SantiagoP1405/traxxas_2026/README.md

# traxxas_2026
Description will be added later.

Clone repository
```
cd
mkdir Workspaces/
cd Workspaces
mkdir traxxas_ws
cd traxxas_ws
git clone https://github.com/SantiagoP1405/traxxas_2026.git
mv traxxas_2026/ src/
colcon build
source install/setup.bash
```
