SantiagoP1405/traxxas_2026/traxxas_robot_simulation/tools/track_img.png

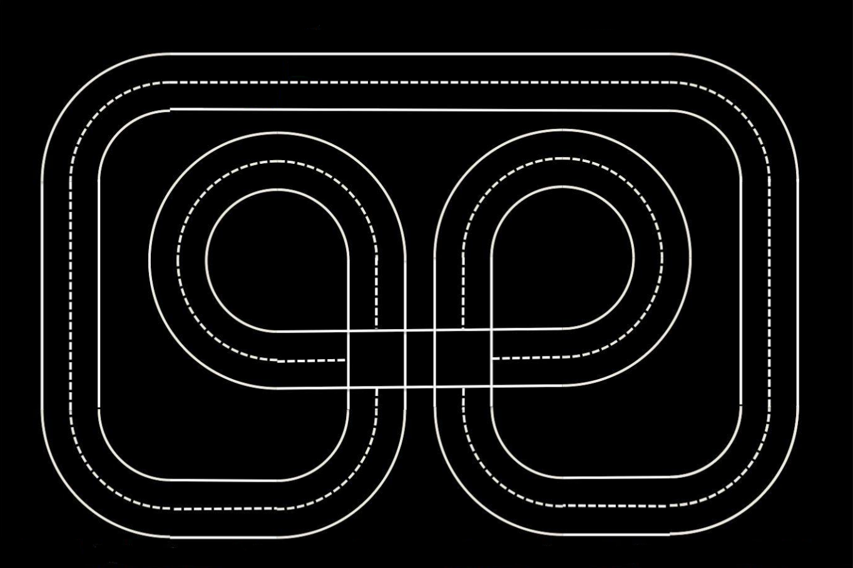
traxxas_robot_simulation/tools/track_img.png
