SantiagoP1405/traxxas_2026/CAD/TRAXXAS_V4/MODEL/rplidar-a2-low-cost-360-degree-laser-range-scanner-1.snapshot.2/LIDAR.png

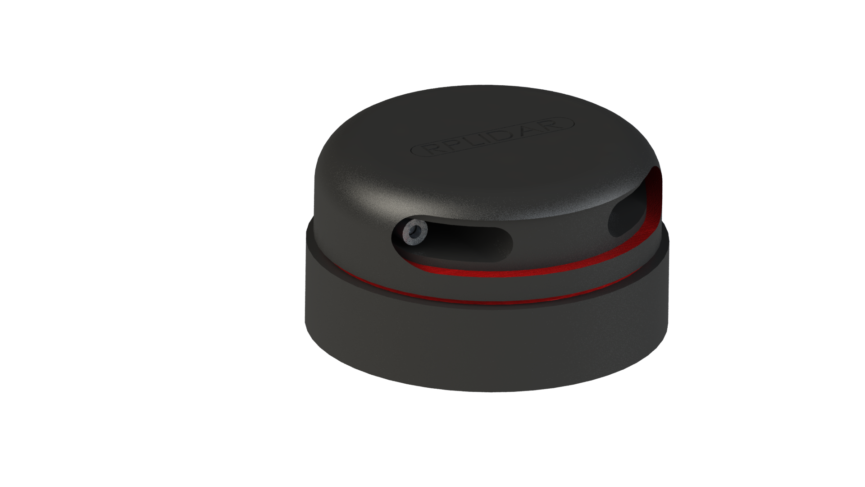
CAD/TRAXXAS_V4/MODEL/rplidar-a2-low-cost-360-degree-laser-range-scanner-1.snapshot.2/LIDAR.png
