SantiagoP1405/traxxas_2026/CAD/DISPLAY_BASE/MODEL/ensamblaje_base.SLDASM

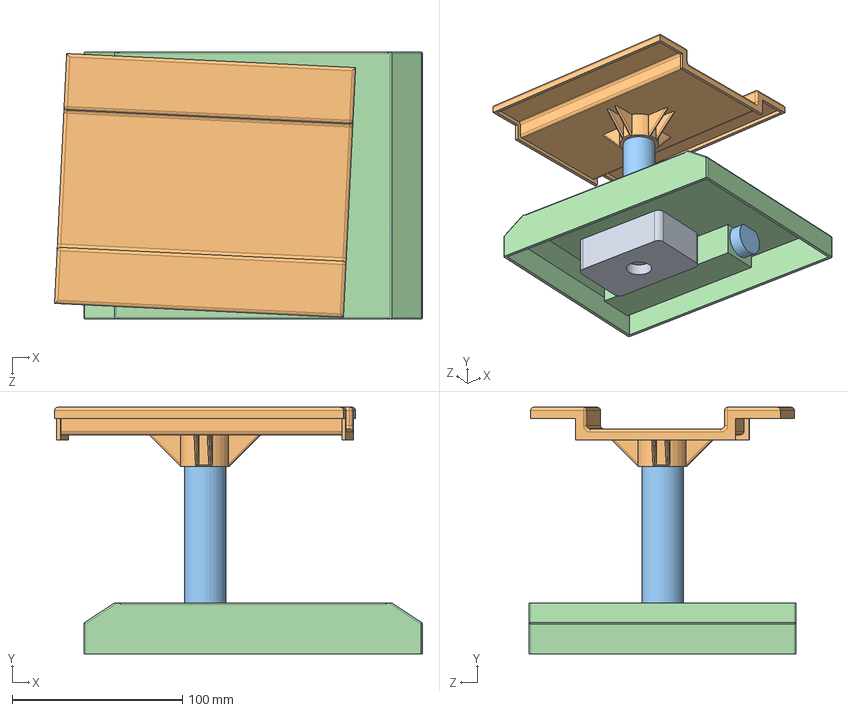
[picture p3: CAD file, 2026-06-15]
CAD/DISPLAY_BASE/MODEL/ensamblaje_base.SLDASM
216.2 x 144.9 x 157.0 mm
base_inferior
pilar x 2
base_superior
soporte
