SantiagoP1405/traxxas_2026/CAD/TRAXXAS_V4/MODEL/rplidar-a2-low-cost-360-degree-laser-range-scanner-1.snapshot.2/LIDAR.STEP

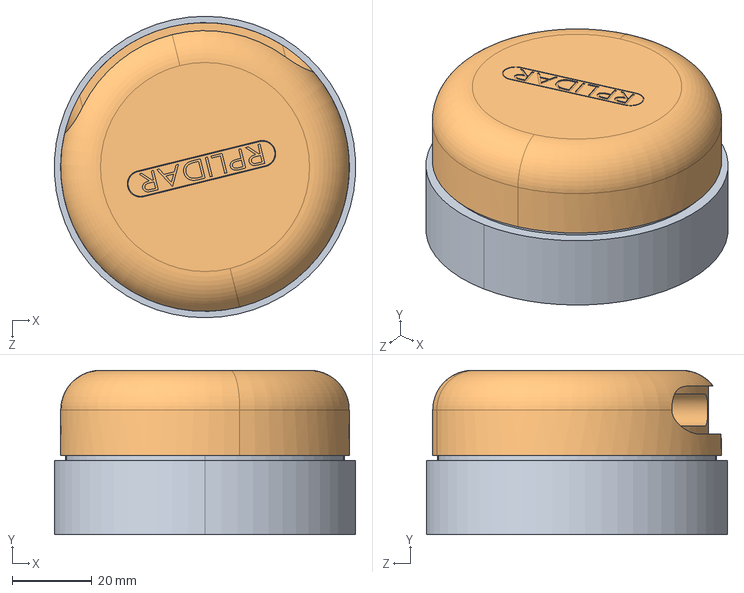
[picture p4: CAD file, 2026-06-16]
CAD/TRAXXAS_V4/MODEL/rplidar-a2-low-cost-360-degree-laser-range-scanner-1.snapshot.2/LIDAR.STEP
75.6 x 41.3 x 75.7 mm
LIDAR_2
LIDAR_1
