SantiagoP1405/traxxas_2026/CAD/DISPLAY_BASE/MODEL/base_superior.SLDPRT

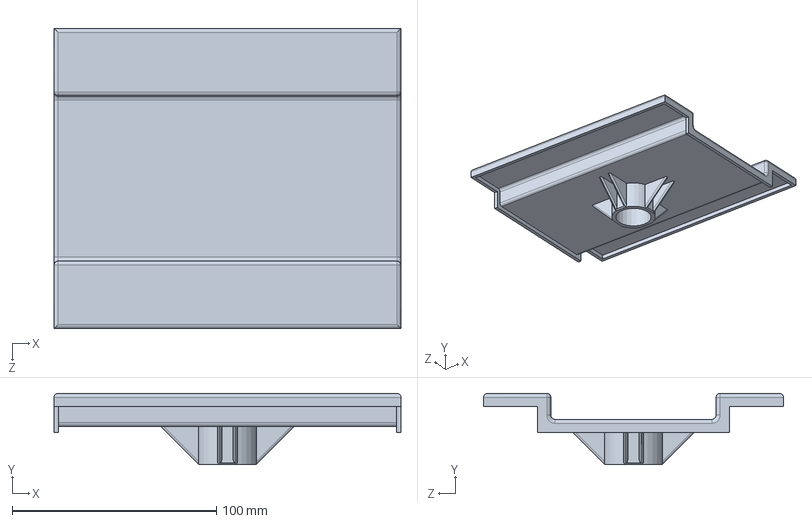
[picture p5: CAD file, 2026-06-15]
CAD/DISPLAY_BASE/MODEL/base_superior.SLDPRT
170.0 x 34.9 x 147.0 mm
