SantiagoP1405/traxxas_2026/CAD/TRAXXAS_V4/MODEL/rplidar-a2-low-cost-360-degree-laser-range-scanner-1.snapshot.2/LIDAR_1.STEP

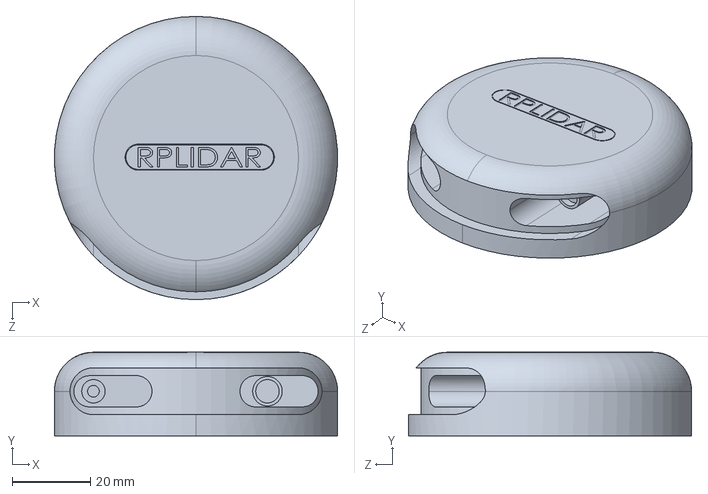
[picture p6: CAD file, 2026-06-16]
CAD/TRAXXAS_V4/MODEL/rplidar-a2-low-cost-360-degree-laser-range-scanner-1.snapshot.2/LIDAR_1.STEP
72.4 x 21.4 x 72.5 mm
