SantiagoP1405/traxxas_2026/CAD/TRAXXAS_V4/MODEL/tapa_lidar.SLDPRT

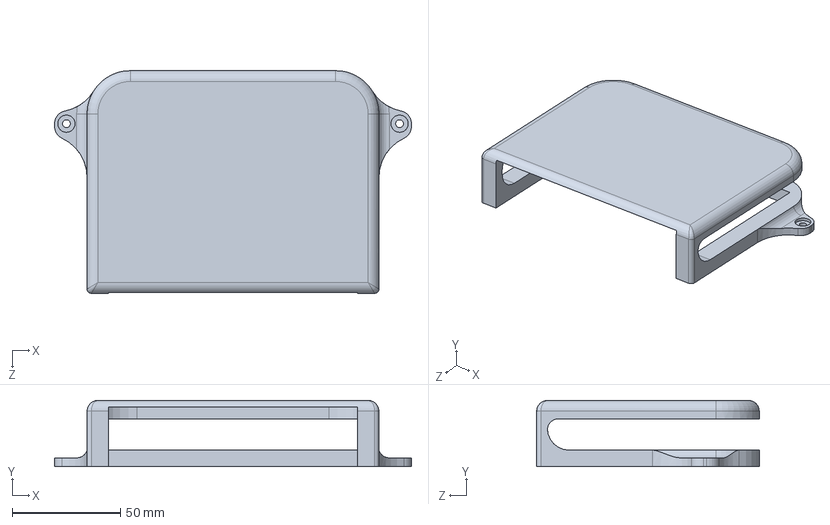
[picture p7: CAD file, 2026-06-16]
CAD/TRAXXAS_V4/MODEL/tapa_lidar.SLDPRT
165.1 x 30.6 x 103.0 mm
