SantiagoP1405/traxxas_2026/CAD/TRAXXAS_V4/STL/tapa_conector_slamtec.STL

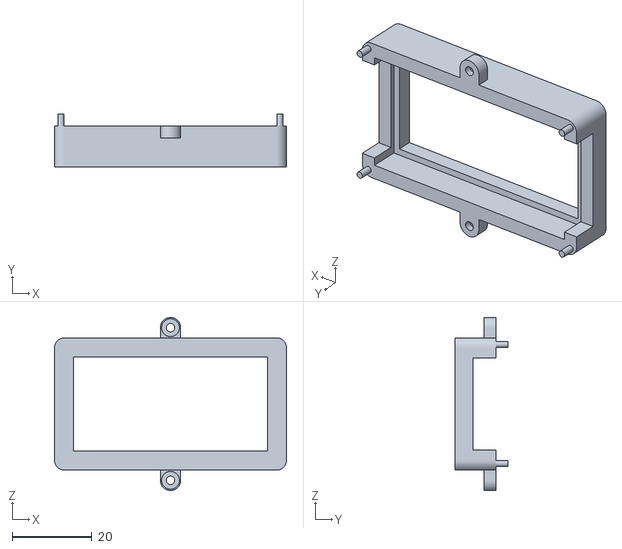
[picture p8: CAD file, 2026-06-16]
CAD/TRAXXAS_V4/STL/tapa_conector_slamtec.STL
58.2 x 13.2 x 43.4
