SantiagoP1405/traxxas_2026/CAD/DISPLAY_BASE/MODEL/soporte.SLDPRT

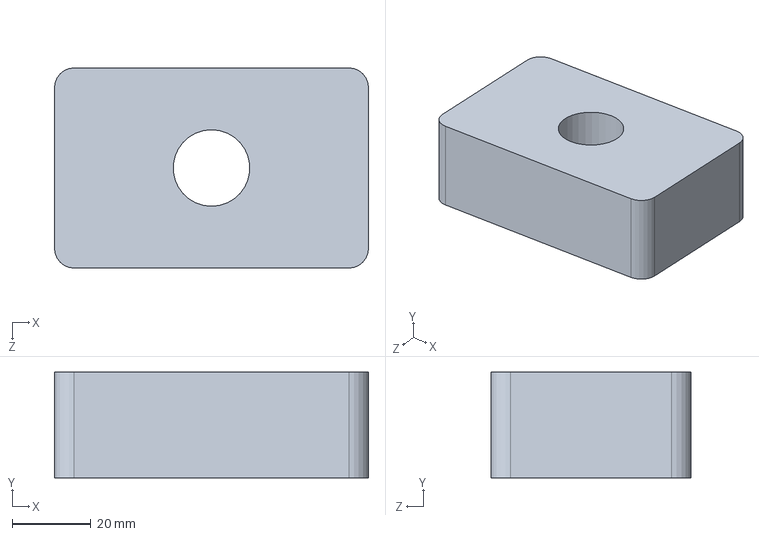
[picture p9: CAD file, 2026-06-15]
CAD/DISPLAY_BASE/MODEL/soporte.SLDPRT
80.0 x 27.0 x 51.0 mm
