SantiagoP1405/traxxas_2026/CAD/TRAXXAS_V4/MODEL/Carroceria2_2.SLDPRT

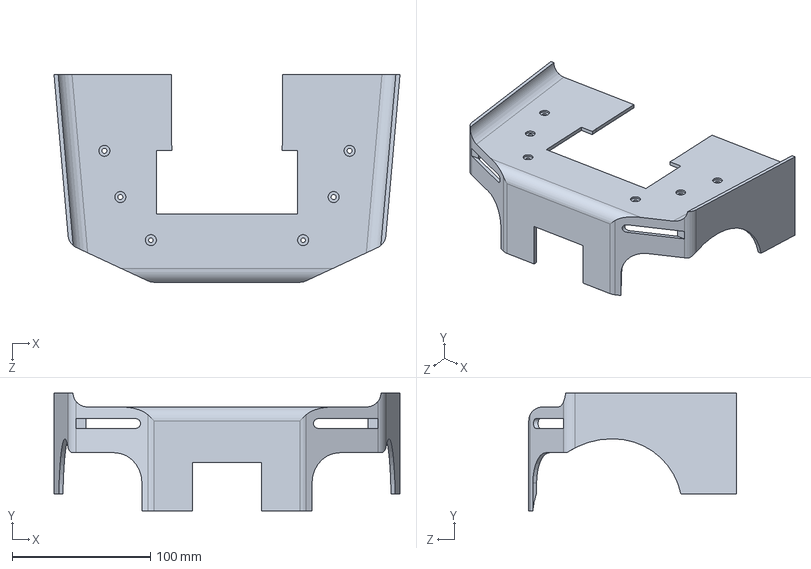
[picture p10: CAD file, 2026-06-16]
CAD/TRAXXAS_V4/MODEL/Carroceria2_2.SLDPRT
250.0 x 85.0 x 150.0 mm
