SantiagoP1405/traxxas_2026/CAD/TRAXXAS_V4/MODEL/rplidar-a2-low-cost-360-degree-laser-range-scanner-1.snapshot.2/LIDAR_2.STEP

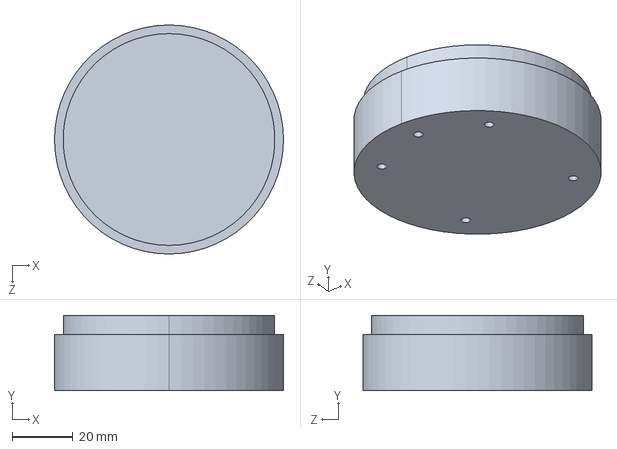
[picture p11: CAD file, 2026-06-16]
CAD/TRAXXAS_V4/MODEL/rplidar-a2-low-cost-360-degree-laser-range-scanner-1.snapshot.2/LIDAR_2.STEP
75.7 x 24.9 x 75.7 mm
