SantiagoP1405/traxxas_2026/CAD/TRAXXAS_V4/STL/aros_suspension_V2.STL

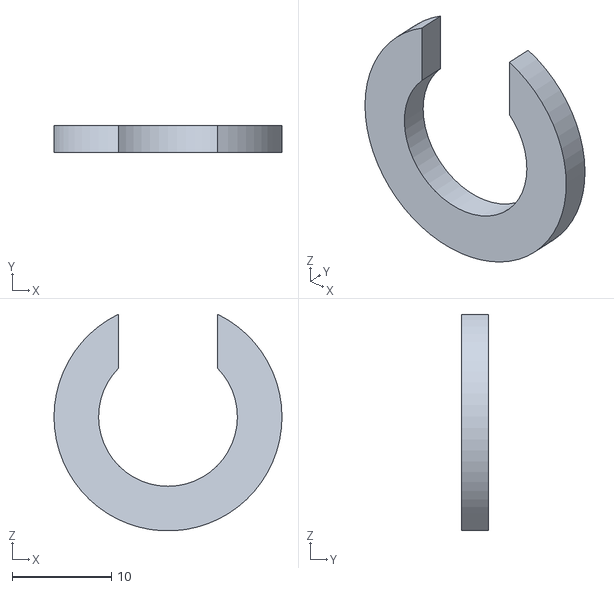
[picture p12: CAD file, 2026-06-16]
CAD/TRAXXAS_V4/STL/aros_suspension_V2.STL
23.0 x 2.75 x 21.8
