SantiagoP1405/traxxas_2026/CAD/DISPLAY_BASE/MODEL/base_inferior.SLDPRT

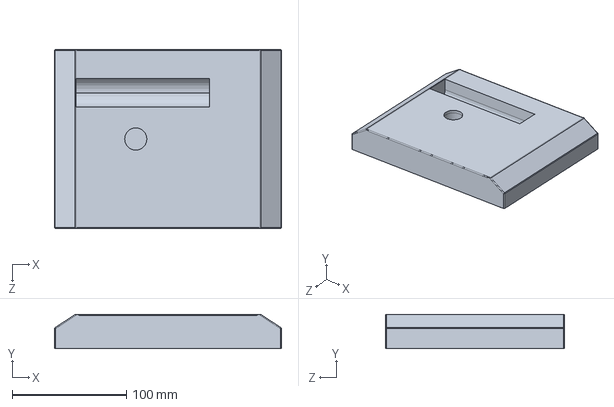
[picture p13: CAD file, 2026-06-15]
CAD/DISPLAY_BASE/MODEL/base_inferior.SLDPRT
199.0 x 30.0 x 157.0 mm
