SantiagoP1405/traxxas_2026/CAD/DISPLAY_BASE/MODEL/pilar_v2.SLDPRT

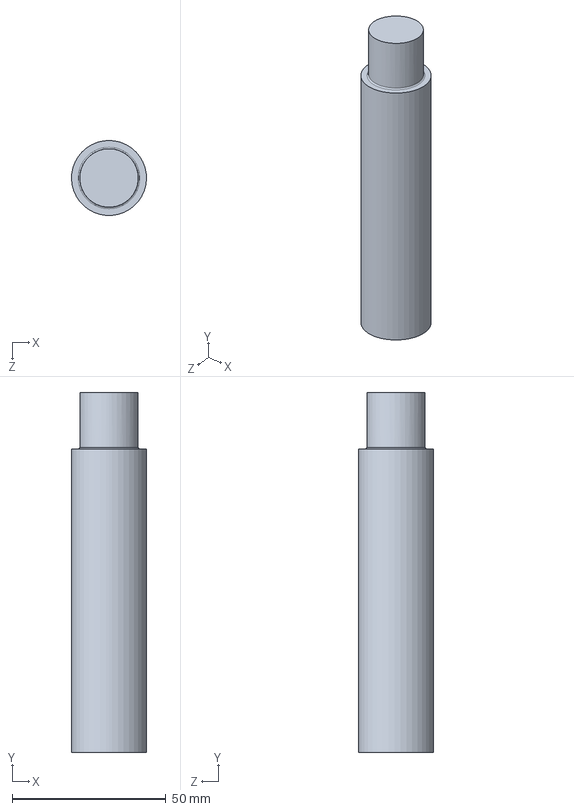
[picture p14: CAD file, 2026-06-15]
CAD/DISPLAY_BASE/MODEL/pilar_v2.SLDPRT
24.4 x 117.0 x 24.4 mm
