SantiagoP1405/traxxas_2026/CAD/TRAXXAS_V4/MODEL/Carroceria2_1_4.SLDPRT

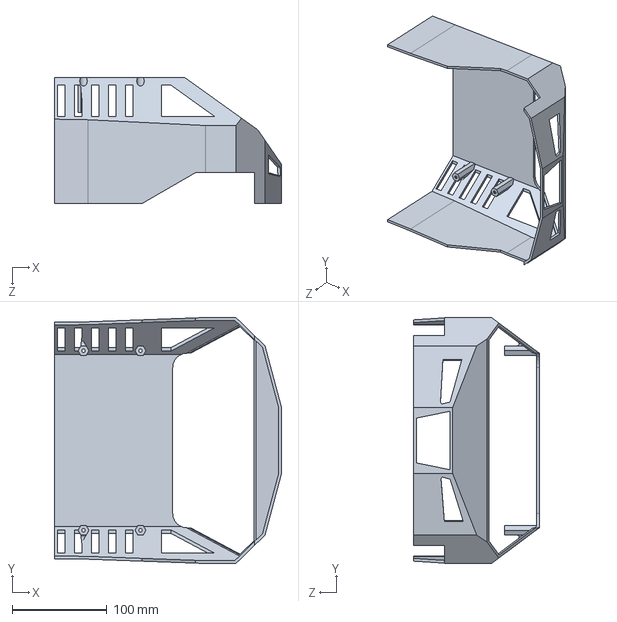
[picture p15: CAD file, 2026-06-16]
CAD/TRAXXAS_V4/MODEL/Carroceria2_1_4.SLDPRT
240.0 x 260.0 x 133.0 mm
