SantiagoP1405/traxxas_2026/CAD/TRAXXAS_V4/STL/test_ultrasonico_v3_1.STL

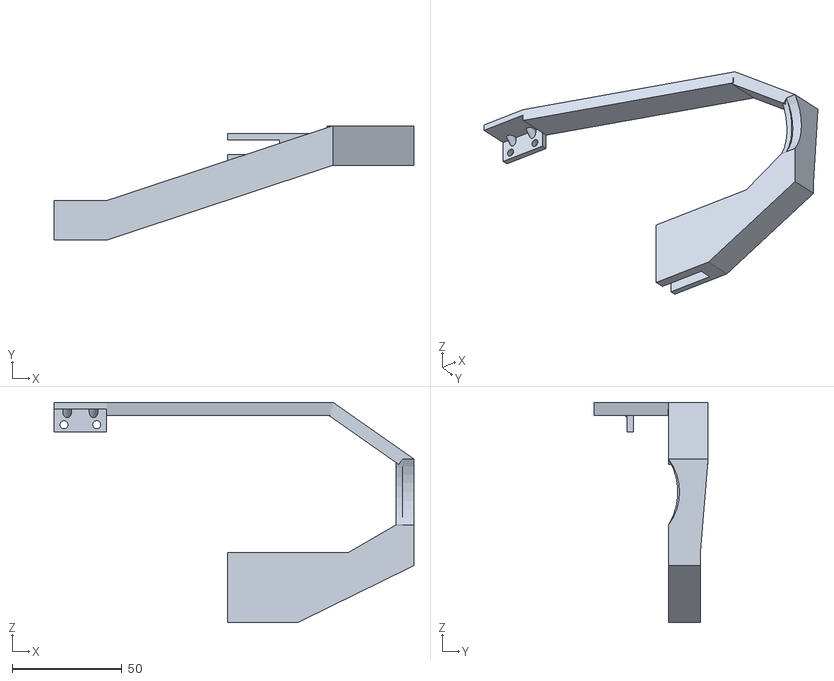
[picture p16: CAD file, 2026-06-16]
CAD/TRAXXAS_V4/STL/test_ultrasonico_v3_1.STL
163.9 x 52.0 x 100.3
