SantiagoP1405/traxxas_2026/CAD/TRAXXAS_V4/MODEL/HC-SR04.SLDPRT

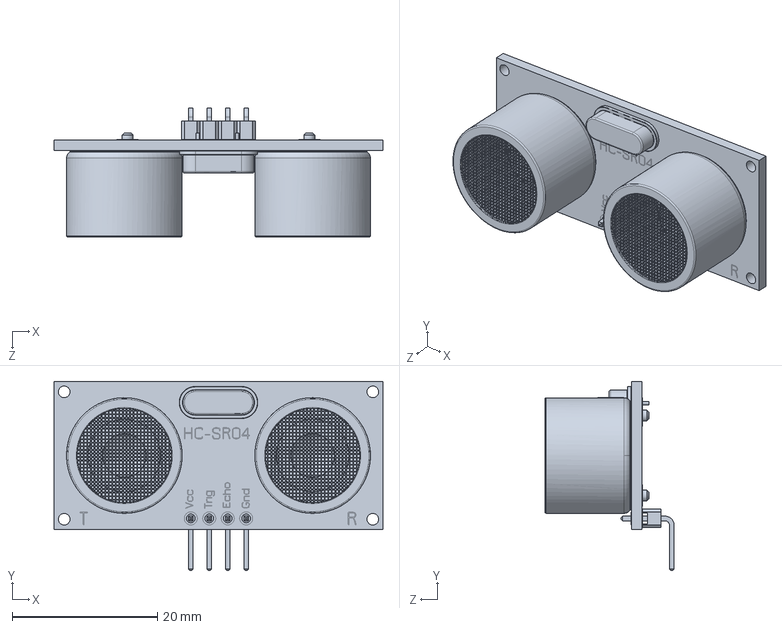
[picture p17: CAD file, 2026-06-16]
CAD/TRAXXAS_V4/MODEL/HC-SR04.SLDPRT
45.2 x 26.0 x 17.8 mm
