SantiagoP1405/traxxas_2026/CAD/TRAXXAS_V4/STL/test_ultrasonico_trasero.STL

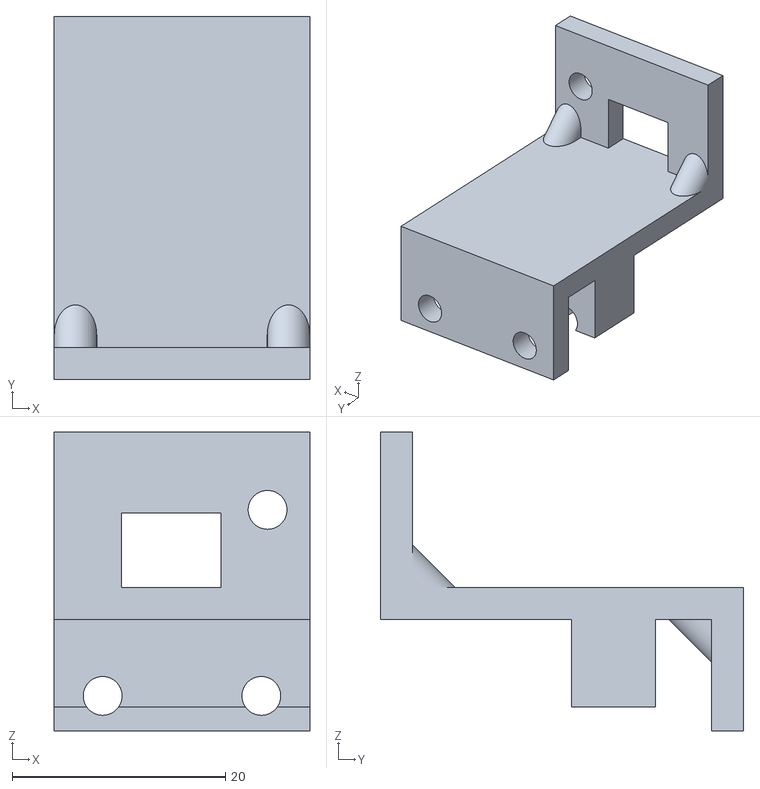
[picture p18: CAD file, 2026-06-16]
CAD/TRAXXAS_V4/STL/test_ultrasonico_trasero.STL
24.0 x 34.1 x 28.1
