SantiagoP1405/traxxas_2026/CAD/TRAXXAS_V4/MODEL/segundo_piso_v3_2.SLDPRT

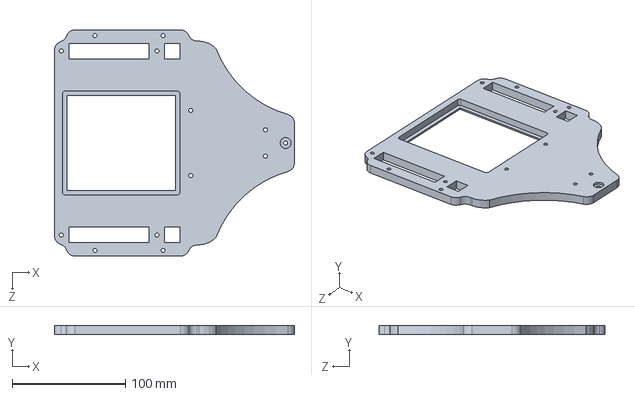
[picture p19: CAD file, 2026-06-16]
CAD/TRAXXAS_V4/MODEL/segundo_piso_v3_2.SLDPRT
212.0 x 8.00 x 200.0 mm
