SantiagoP1405/traxxas_2026/CAD/TRAXXAS_V4/STL/base_conector_slamtec.STL

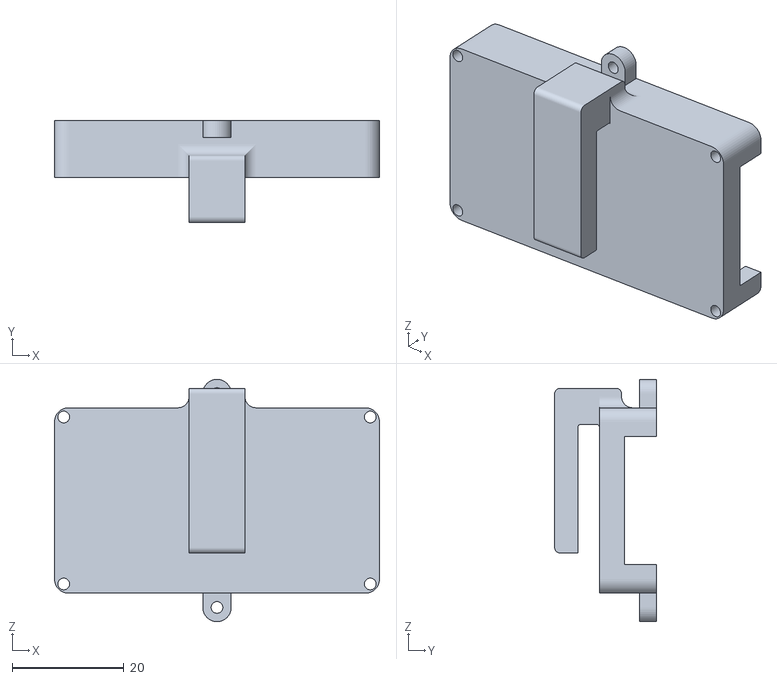
[picture p20: CAD file, 2026-06-16]
CAD/TRAXXAS_V4/STL/base_conector_slamtec.STL
58.2 x 18.2 x 43.4
