SantiagoP1405/traxxas_2026/CAD/TRAXXAS_V4/MODEL/separador_30mm.SLDPRT

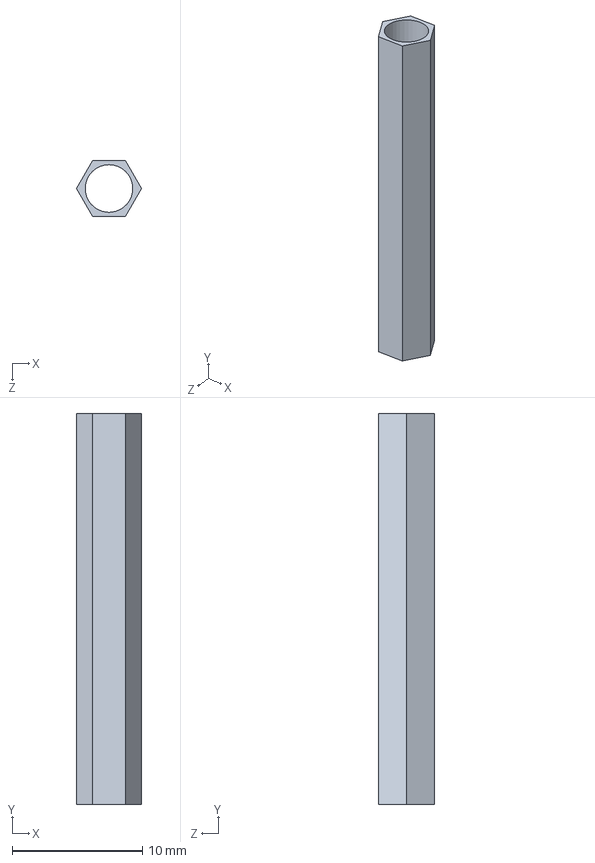
[picture p21: CAD file, 2026-06-16]
CAD/TRAXXAS_V4/MODEL/separador_30mm.SLDPRT
5.00 x 30.0 x 4.33 mm
