SantiagoP1405/traxxas_2026/CAD/TRAXXAS_V4/STL/hexagonos_llantas.STL

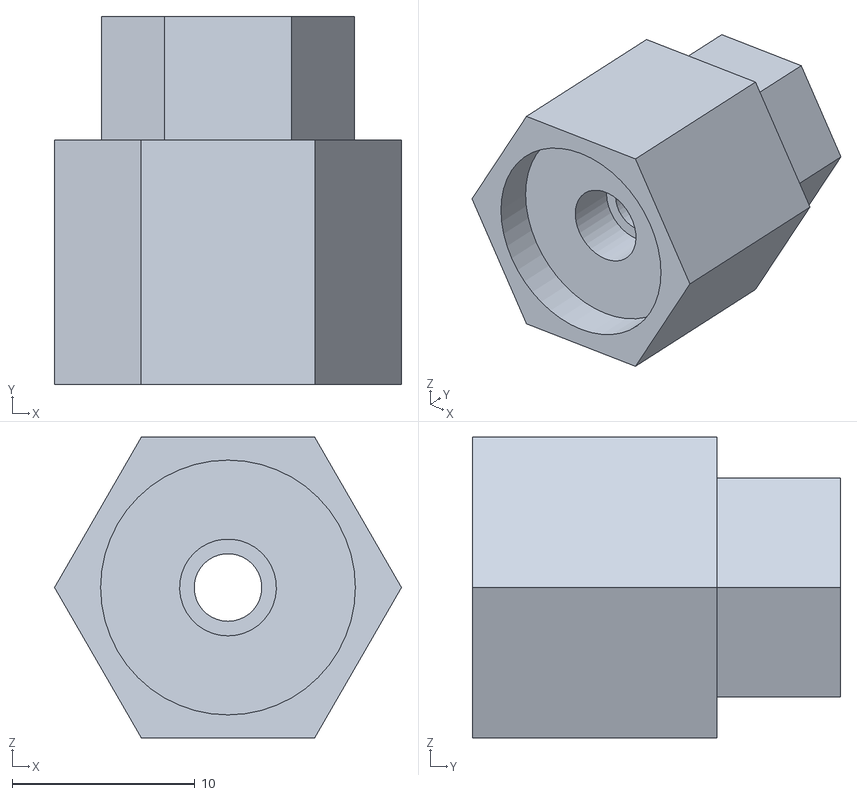
[picture p22: CAD file, 2026-06-16]
CAD/TRAXXAS_V4/STL/hexagonos_llantas.STL
19.0 x 20.1 x 16.5
