SantiagoP1405/traxxas_2026/CAD/TRAXXAS_V4/MODEL/base_rplidar_adapter.SLDPRT

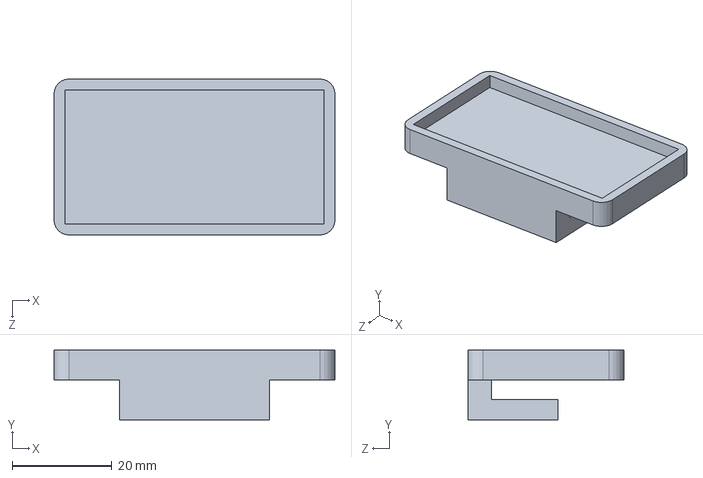
[picture p23: CAD file, 2026-06-16]
CAD/TRAXXAS_V4/MODEL/base_rplidar_adapter.SLDPRT
56.2 x 14.0 x 31.2 mm
