SantiagoP1405/traxxas_2026/CAD/TRAXXAS_V4/STL/test_tuerca.STL

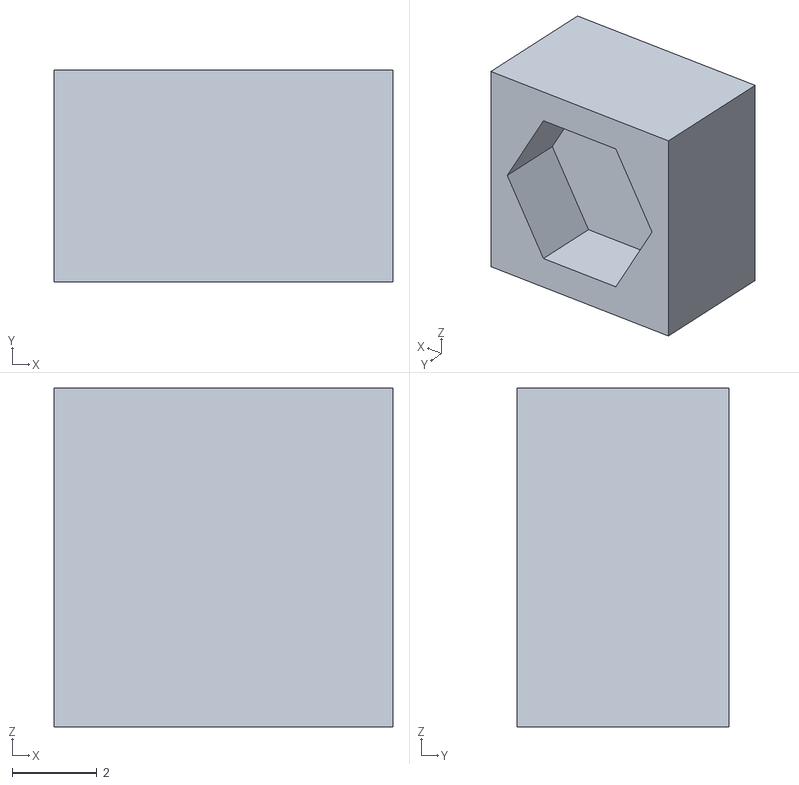
[picture p24: CAD file, 2026-06-16]
CAD/TRAXXAS_V4/STL/test_tuerca.STL
8.00 x 5.00 x 8.00
