SantiagoP1405/traxxas_2026/CAD/TRAXXAS_V4/MODEL/primer_piso.SLDPRT

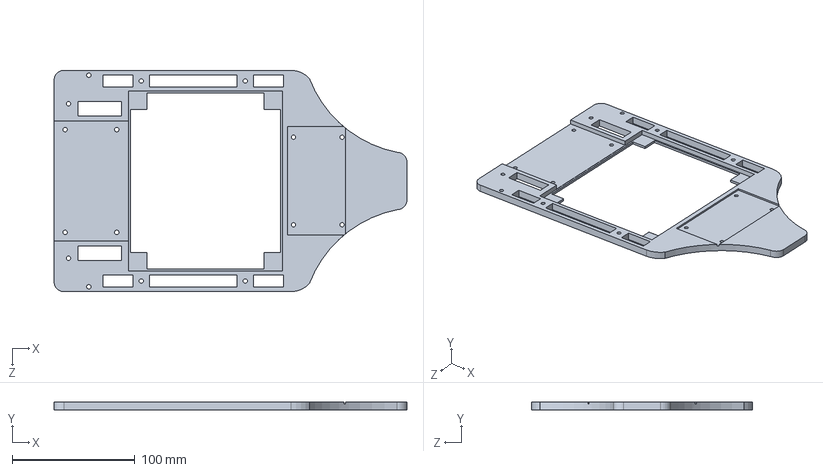
[picture p25: CAD file, 2026-06-16]
CAD/TRAXXAS_V4/MODEL/primer_piso.SLDPRT
287.0 x 6.35 x 180.0 mm
