SantiagoP1405/traxxas_2026/CAD/TRAXXAS_V4/MODEL/base_lidar.SLDPRT

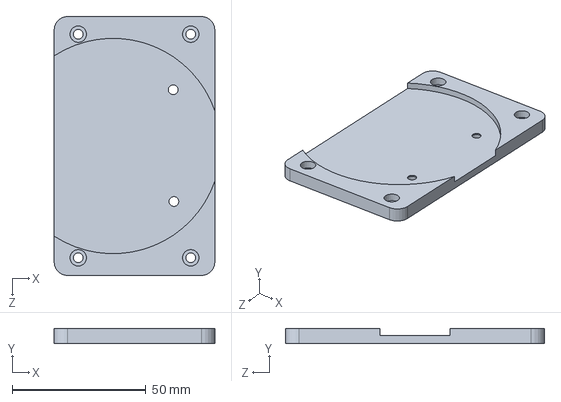
[picture p26: CAD file, 2026-06-16]
CAD/TRAXXAS_V4/MODEL/base_lidar.SLDPRT
60.0 x 5.50 x 96.7 mm
