SantiagoP1405/traxxas_2026/CAD/TRAXXAS_V4/MODEL/separador.SLDPRT

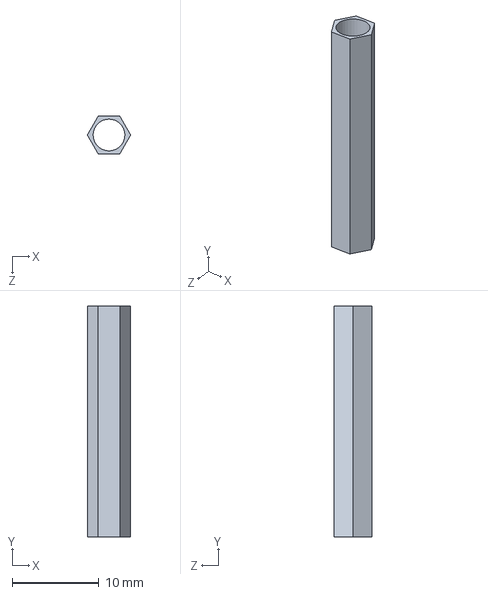
[picture p27: CAD file, 2026-06-16]
CAD/TRAXXAS_V4/MODEL/separador.SLDPRT
5.00 x 26.6 x 4.33 mm
