SantiagoP1405/traxxas_2026/CAD/TRAXXAS_V4/MODEL/base_ultrasonico_trasero_v3.SLDPRT

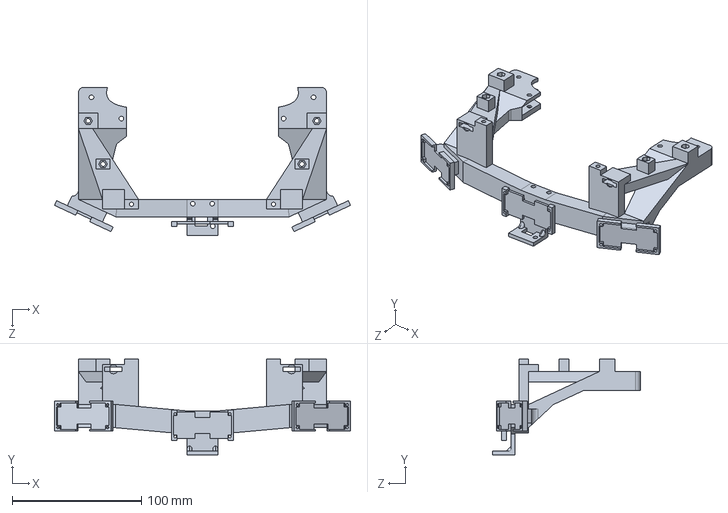
[picture p28: CAD file, 2026-06-16]
CAD/TRAXXAS_V4/MODEL/base_ultrasonico_trasero_v3.SLDPRT
229.3 x 74.3 x 114.9 mm
