SantiagoP1405/traxxas_2026/CAD/TRAXXAS_V4/MODEL/separador_15mm.SLDPRT

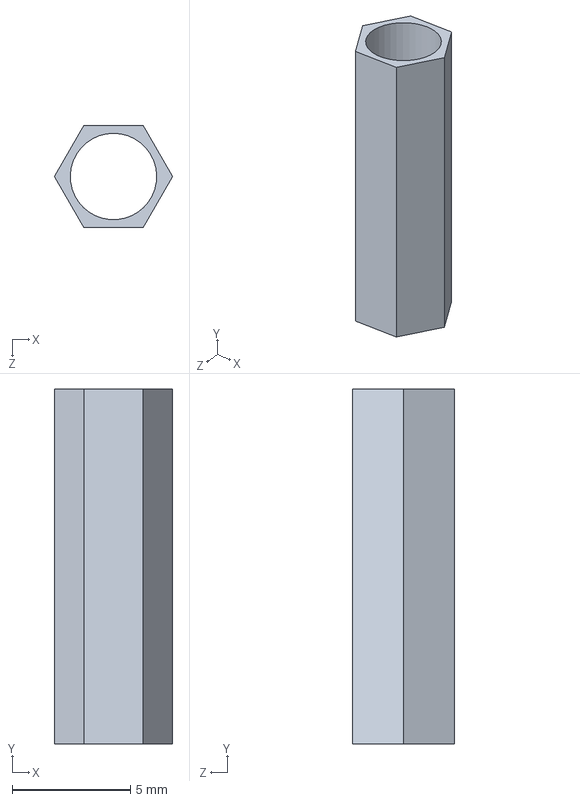
[picture p29: CAD file, 2026-06-16]
CAD/TRAXXAS_V4/MODEL/separador_15mm.SLDPRT
5.00 x 15.0 x 4.33 mm
