SantiagoP1405/traxxas_2026/CAD/TRAXXAS_V4/MODEL/base_zed.SLDPRT

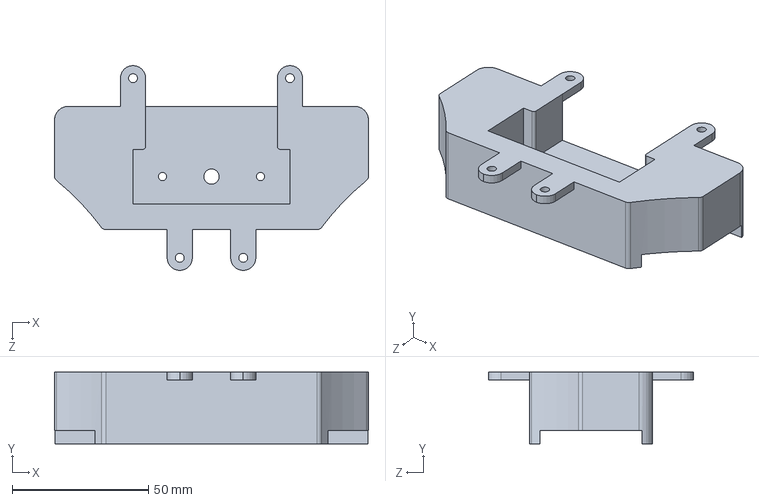
[picture p30: CAD file, 2026-06-15]
CAD/TRAXXAS_V4/MODEL/base_zed.SLDPRT
115.4 x 26.4 x 75.3 mm
