SantiagoP1405/traxxas_2026/CAD/TRAXXAS_V4/MODEL/ensamblaje_sin_jetson.SLDASM

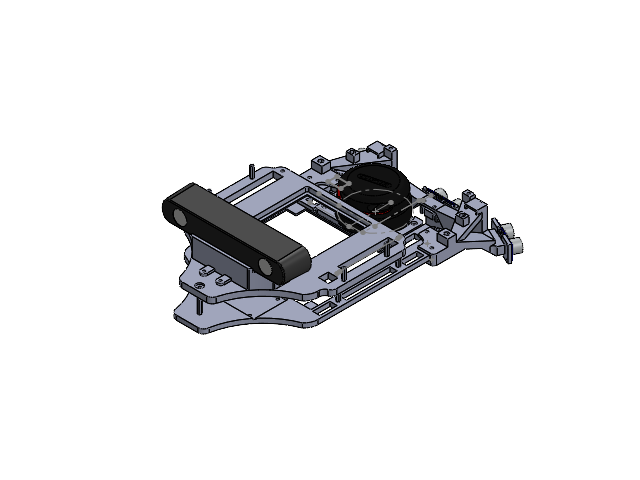
[picture p32: CAD file, 2026-06-16]
CAD/TRAXXAS_V4/MODEL/ensamblaje_sin_jetson.SLDASM
segundo_piso_v3_2
separador x 4
primer_piso
base_ultrasonico_trasero_v3
base_zed
optic_2.step x 2
eBom-FreeParts_2.step
separador_30mm
base_lidar
LIDAR_2
LIDAR_1
HC-SR04 x 3
leds Geometry.stp
pin.stp
smd_10k Geometry.stp x 2
cover.stp x 2
smd_150 Geometry.stp
cover2.stp
Surf Geometry.stp x 2
cover3.stp x 2
smd_1k Geometry.stp x 2
cover4.stp x 2
IC_smd_8.stp
LED_SMD.stp x 2
pot Geometry.stp
pin2.stp
leds2 Geometry.stp
pins.stp
Board Geometry.stp
TXT.stp
4PinsOut Geometry.stp
pin3.stp
TCRT5000_1.stp
separador_15mm x 4
