SantiagoP1405/traxxas_2026/CAD/TRAXXAS_V4/MODEL/ensamblaje_lidar.SLDASM

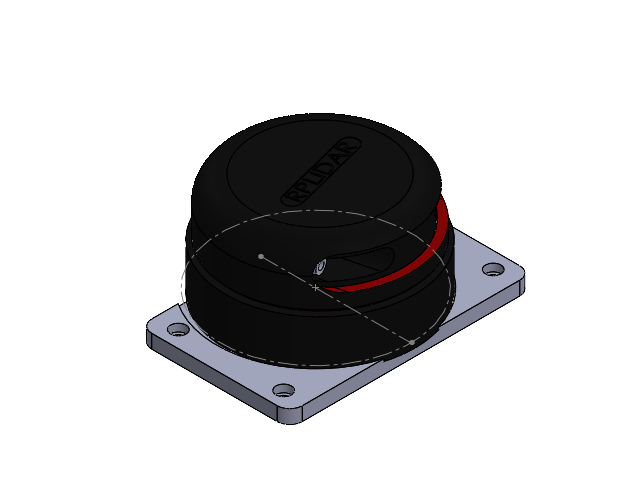
[picture p33: CAD file, 2026-06-16]
CAD/TRAXXAS_V4/MODEL/ensamblaje_lidar.SLDASM
base_lidar
LIDAR_2
LIDAR_1
