SantiagoP1405/traxxas_2026/CAD/TRAXXAS_V4/MODEL/ensamblaje_basez_2_zed.SLDASM

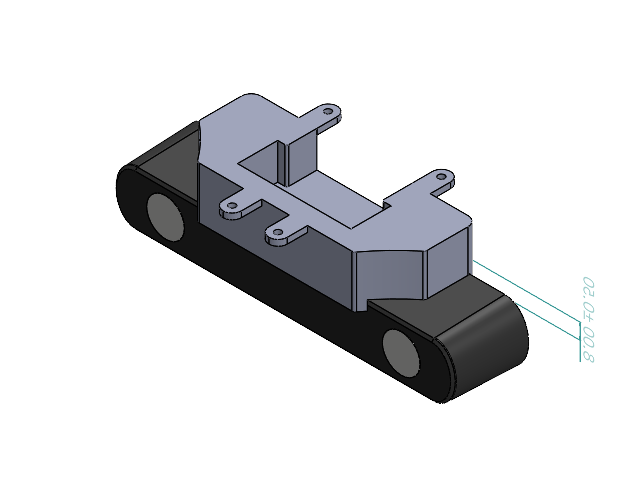
[picture p34: CAD file, 2026-06-15]
CAD/TRAXXAS_V4/MODEL/ensamblaje_basez_2_zed.SLDASM
base_zed
optic_2.step x 2
eBom-FreeParts_2.step
