SantiagoP1405/traxxas_2026/(list of files, cad)

Other CAD files:
CAD/DISPLAY_BASE/MODEL/pilar.SLDPRT
CAD/DISPLAY_BASE/DRAW/base_inferior.SLDDRW
CAD/DISPLAY_BASE/DRAW/base_superior.SLDDRW
CAD/DISPLAY_BASE/DRAW/pilar.SLDDRW
CAD/DISPLAY_BASE/DRAW/pilar_v2.SLDDRW
CAD/DISPLAY_BASE/DRAW/soporte.SLDDRW
CAD/DISPLAY_BASE/STL/base_inferior.STL
CAD/DISPLAY_BASE/STL/base_superior.STL
CAD/DISPLAY_BASE/STL/pilar.STL
CAD/DISPLAY_BASE/STL/soporte.STL
CAD/TRAXXAS_V1/DRAW/platform_deck_technical_drawing.dwg
CAD/TRAXXAS_V1/DRAW/platform_deck_v3_2_technical_drawing.dwg
CAD/TRAXXAS_V1/DRAW/platform_deck_v3_3_technical_drawing.dwg
CAD/TRAXXAS_V1/MODEL/Platform_Deck.ipt
CAD/TRAXXAS_V1/MODEL/Platform_Deck_V3_2.ipt
CAD/TRAXXAS_V1/MODEL/Platform_Deck_V3_3.ipt
CAD/TRAXXAS_V1/MODEL/platform_deck.ipt
CAD/TRAXXAS_V1/MODEL/platform_deck_v3_2.ipt
CAD/TRAXXAS_V1/MODEL/platform_deck_v3_3.ipt
CAD/TRAXXAS_V2/DRAW/base_lidar.SLDDRW
CAD/TRAXXAS_V2/DRAW/primer_piso_v2.SLDDRW
CAD/TRAXXAS_V2/DRAW/right_base_ultrasonic.SLDDRW
CAD/TRAXXAS_V2/DRAW/segundo_piso.SLDDRW
CAD/TRAXXAS_V2/MODEL/HC-SR04.SLDPRT
CAD/TRAXXAS_V2/MODEL/base_lidar.SLDPRT
CAD/TRAXXAS_V2/MODEL/left_ultrasonic_2_base - copia.SLDASM
CAD/TRAXXAS_V2/MODEL/primer_piso_v2.SLDPRT
CAD/TRAXXAS_V2/MODEL/right_base_ultrasonic.SLDPRT
CAD/TRAXXAS_V2/MODEL/right_ultrasonic_2_base.SLDASM
CAD/TRAXXAS_V2/MODEL/segundo_piso.SLDPRT
CAD/TRAXXAS_V3/DRAW/carroceria_atras.SLDDRW
CAD/TRAXXAS_V3/DRAW/carroceria_frente.SLDDRW
CAD/TRAXXAS_V3/MODEL/LIDAR.SLDASM
CAD/TRAXXAS_V3/MODEL/ZED2i.step
CAD/TRAXXAS_V3/MODEL/aros_suspension_V1.SLDPRT
CAD/TRAXXAS_V3/MODEL/aros_suspension_V2.SLDPRT
CAD/TRAXXAS_V3/MODEL/carroceria_atras.SLDPRT
CAD/TRAXXAS_V3/MODEL/carroceria_frente.SLDPRT
CAD/TRAXXAS_V3/MODEL/hexagonos_llantas.SLDPRT
CAD/TRAXXAS_V3/MODEL/tcrt5000.stp
CAD/TRAXXAS_V3/STL/carroceria_atras.3mf
CAD/TRAXXAS_V3/STL/carroceria_atras.STL
CAD/TRAXXAS_V3/STL/carroceria_frente.3mf
CAD/TRAXXAS_V3/STL/carroceria_frente.STL
CAD/TRAXXAS_V4/DRAW/Carroceria2_1_4.SLDDRW
CAD/TRAXXAS_V4/DRAW/Carroceria2_2.SLDDRW
CAD/TRAXXAS_V4/DRAW/aros_suspension.SLDDRW
CAD/TRAXXAS_V4/DRAW/base_lidar.SLDDRW
CAD/TRAXXAS_V4/DRAW/base_rplidar_adapter.SLDDRW
CAD/TRAXXAS_V4/DRAW/base_ultrasonico_trasero_v3.SLDDRW
CAD/TRAXXAS_V4/DRAW/base_zed.SLDDRW
CAD/TRAXXAS_V4/DRAW/hexagonos_llantas.SLDDRW
CAD/TRAXXAS_V4/DRAW/primer_piso.SLDDRW
CAD/TRAXXAS_V4/DRAW/segundo_piso_v3_2.SLDDRW
CAD/TRAXXAS_V4/DRAW/separador.SLDDRW
CAD/TRAXXAS_V4/DRAW/tapa_lidar.SLDDRW
CAD/TRAXXAS_V4/MODEL/rplidar-a2-low-cost-360-degree-laser-range-scanner-1.snapshot.2/LIDAR.SLDASM
CAD/TRAXXAS_V4/MODEL/rplidar-a2-low-cost-360-degree-laser-range-scanner-1.snapshot.2/LIDAR.SLDPRT
CAD/TRAXXAS_V4/MODEL/rplidar-a2-low-cost-360-degree-laser-range-scanner-1.snapshot.2/LIDAR_1.SLDPRT
CAD/TRAXXAS_V4/MODEL/rplidar-a2-low-cost-360-degree-laser-range-scanner-1.snapshot.2/LIDAR_2.SLDPRT
CAD/TRAXXAS_V4/STL/Carroceria2_1_4.STL
CAD/TRAXXAS_V4/STL/Carroceria2_2.STL
CAD/TRAXXAS_V4/STL/base_lidar.STL
CAD/TRAXXAS_V4/STL/base_rplidar_adapter.STL
CAD/TRAXXAS_V4/STL/base_ultrasonico_trasero_v2.3mf
CAD/TRAXXAS_V4/STL/base_ultrasonico_trasero_v2.STL
CAD/TRAXXAS_V4/STL/base_ultrasonico_trasero_v3.3mf
CAD/TRAXXAS_V4/STL/base_ultrasonico_trasero_v3.STL
CAD/TRAXXAS_V4/STL/primer_piso.STL
CAD/TRAXXAS_V4/STL/segundo_piso_v3_2.STL
CAD/TRAXXAS_V4/STL/tapa_lidar.STL
CAD/TRAXXAS_V4/STL/test_ultrasonico_v3.STL
