SantiagoP1405/traxxas_2026/AI_models/results_lane_detector_m/results.csv

epoch | time | train/box_loss | train/seg_loss | train/cls_loss | train/dfl_loss | train/sem_loss | metrics/precision(B) | metrics/recall(B) | metrics/mAP50(B) | metrics/mAP50-95(B) | metrics/precision(M) | metrics/recall(M) | metrics/mAP50(M) | metrics/mAP50-95(M) | val/box_loss | val/seg_loss | val/cls_loss | val/dfl_loss | val/sem_loss | lr/pg0 | lr/pg1 | lr/pg2
1 | 140.978 | 0.71714 | 0.91427 | 0.87065 | 1.00846 | 0 | 0.67859 | 0.62909 | 0.61956 | 0.49126 | 0.6948 | 0.65338 | 0.62339 | 0.45668 | 0.83601 | 0.74295 | 2.47791 | 1.15765 | 0 | 0.000332288 | 0.000332288 | 0.0671034
2 | 286.201 | 0.70022 | 0.79 | 0.75639 | 0.99613 | 0 | 0.76937 | 0.69865 | 0.73232 | 0.60617 | 0.76487 | 0.70743 | 0.73654 | 0.56025 | 0.69849 | 0.58177 | 1.51866 | 1.08105 | 0 | 0.000661229 | 0.000661229 | 0.0340991
3 | 430.981 | 0.6828 | 0.77687 | 0.71439 | 0.98867 | 0 | 0.73797 | 0.74932 | 0.75818 | 0.60499 | 0.74793 | 0.7518 | 0.76638 | 0.58133 | 0.71419 | 0.60118 | 1.4174 | 1.10313 | 0 | 0.000985769 | 0.000985769 | 0.00109026
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
