SantiagoP1405/traxxas_2026/AI_models/results_lane_detector_m/BoxPR_curve.png

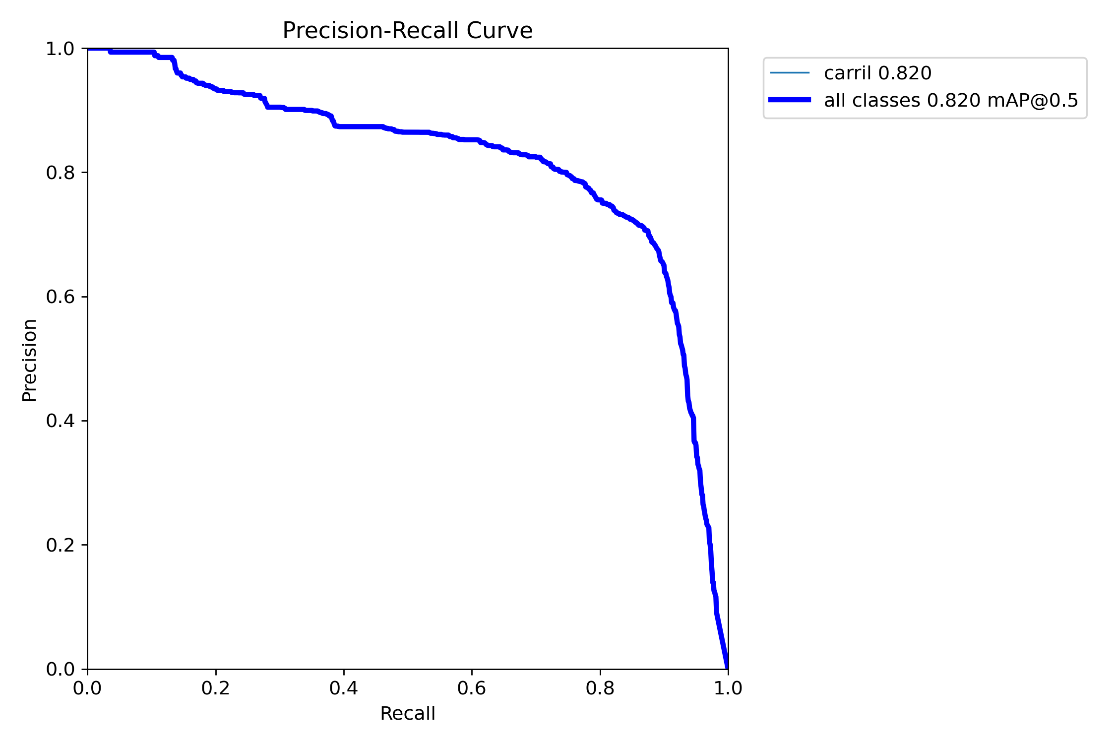
AI_models/results_lane_detector_m/BoxPR_curve.png
