SantiagoP1405/traxxas_2026/AI_models/results_lane_detector_m/confusion_matrix_normalized.png

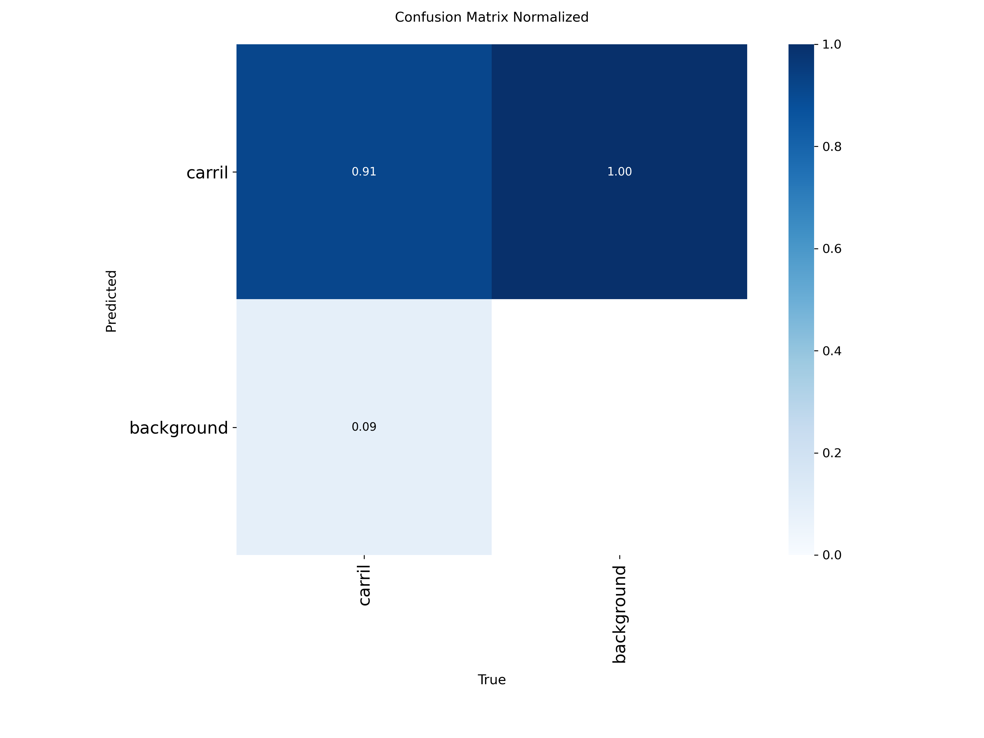
AI_models/results_lane_detector_m/confusion_matrix_normalized.png
