SantiagoP1405/traxxas_2026/CAD/TRAXXAS_V4/DRAW/Carroceria2_1_4.pdf

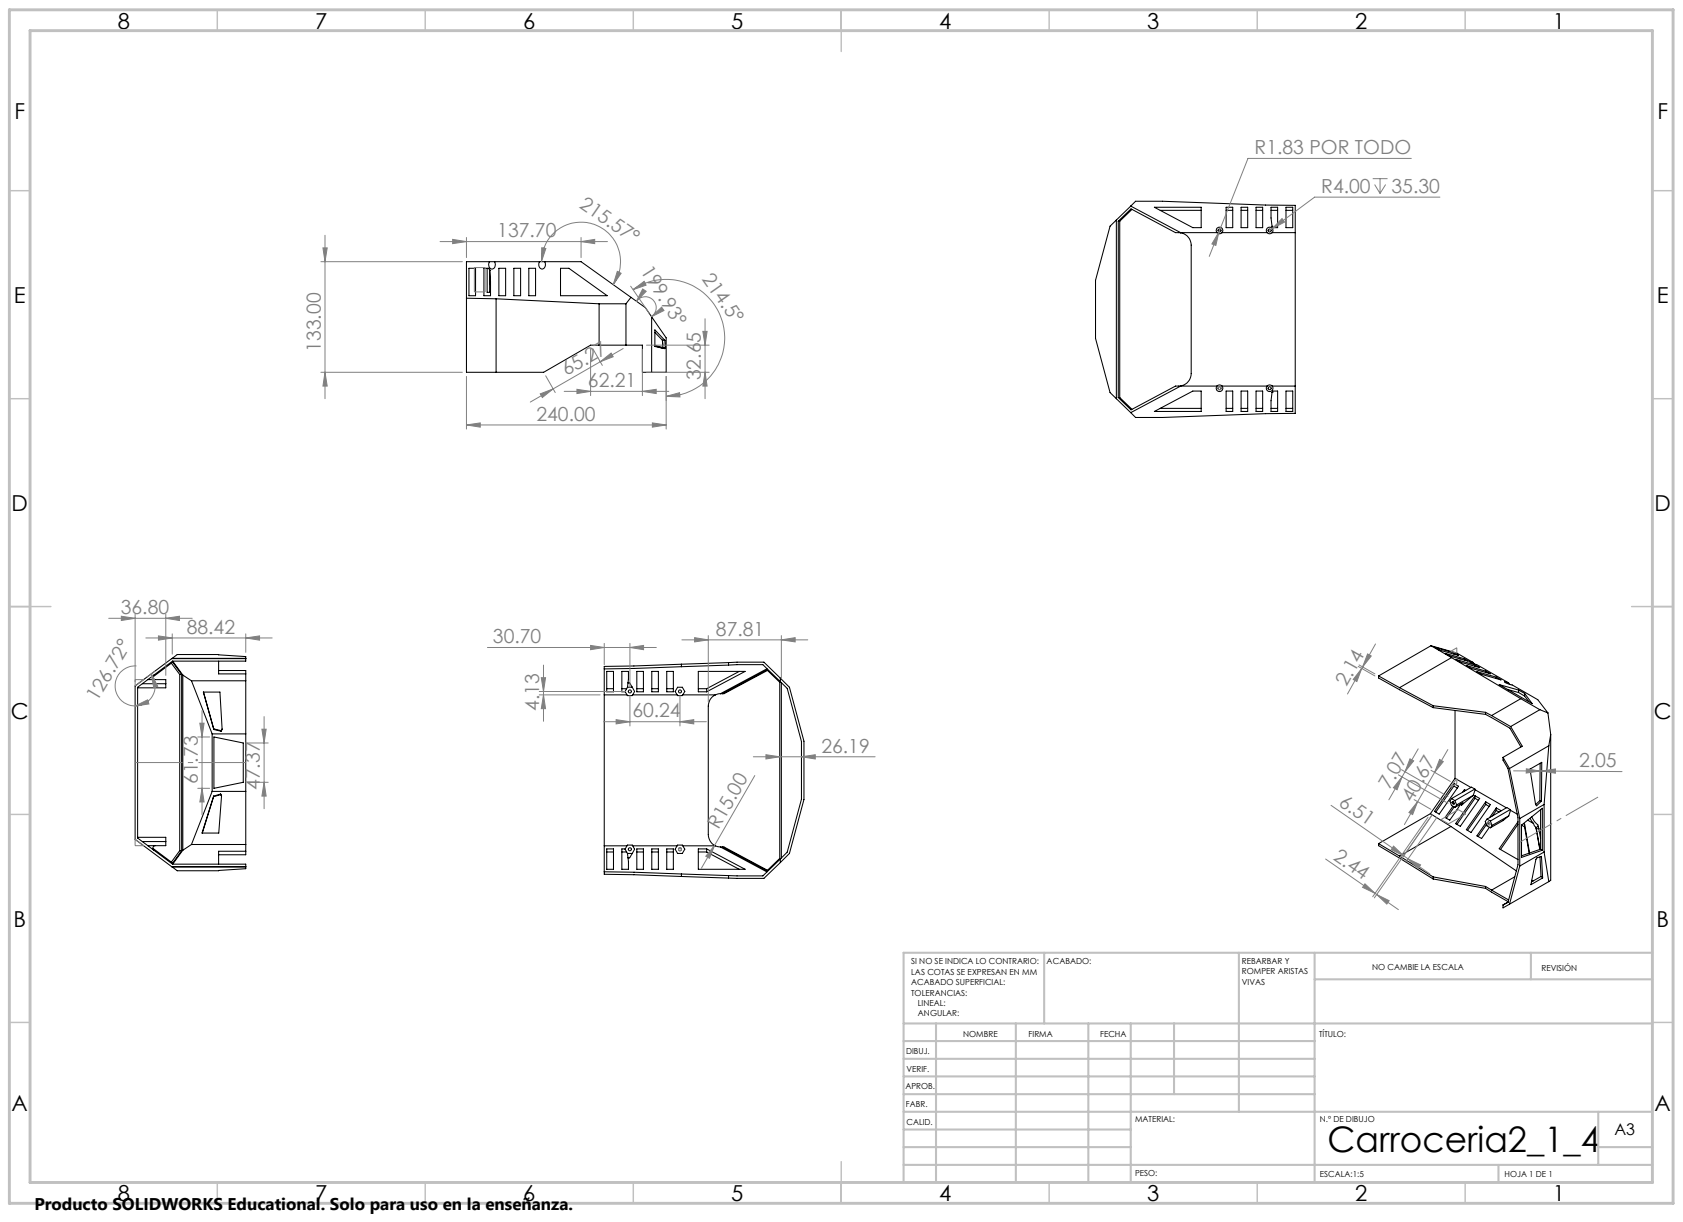
[picture p41: page 1]
R1.83 POR TODO R4.00 35.30; ACABADO:; REBARBAR Y; ROMPER ARISTAS; NO CAMBIE LA ESCALA; REVISIÓN; ESCALA:1:5; HOJA 1 DE 1

SI NO SE INDICA LO CONTRARIO:
LAS COTAS SE EXPRESAN EN MM
ACABADO SUPERFICIAL:
TOLERANCIAS:
LINEAL:
ANGULAR:

NOMBRE | FIRMA | FECHA | | | | TÍTULO:

DIBUJ.
VERIF.
APROB.
FABR.
CALID. | | | | MATERIAL: | N.º DE DIBUJO Carroceria2_1_4 | A3

Producto SOLIDWORKS Educational. Solo para uso en la enseñanza.
