SantiagoP1405/traxxas_2026/CAD/TRAXXAS_V4/DRAW/Carroceria2_2.pdf

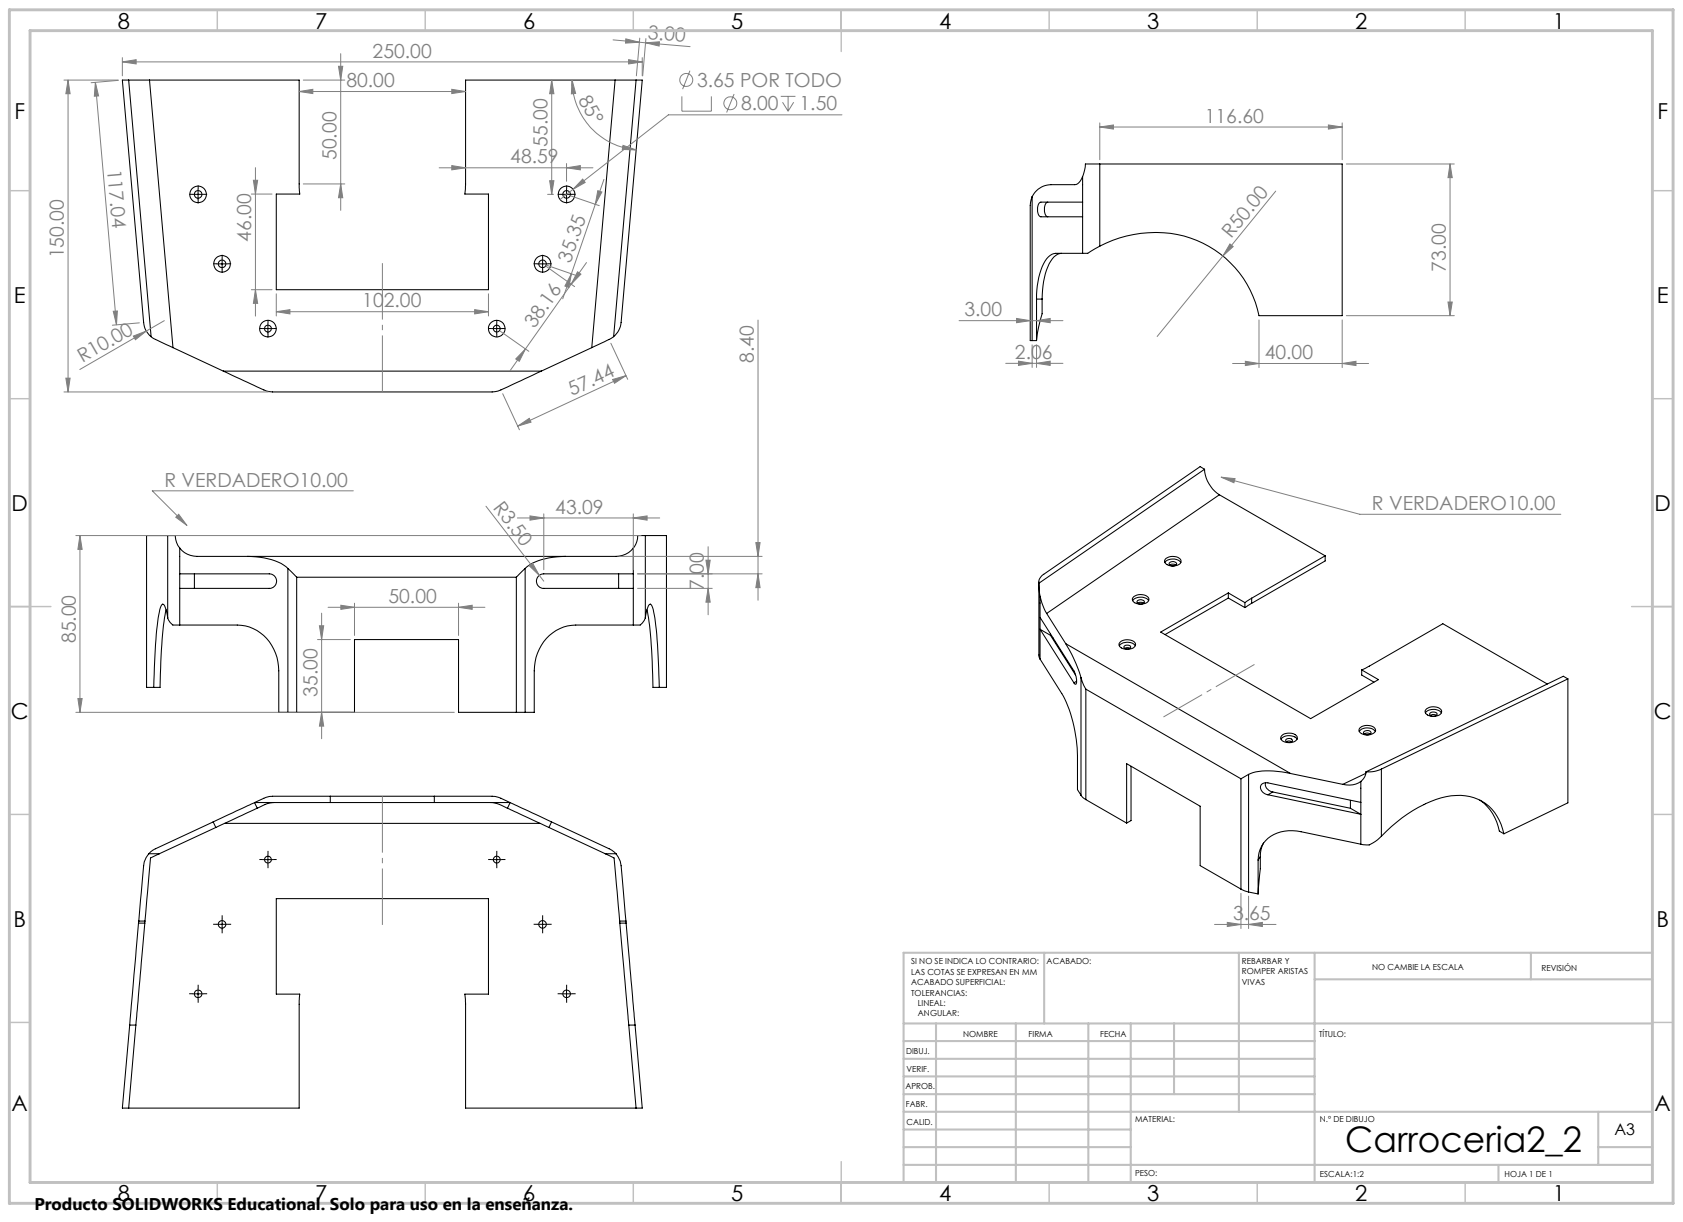
[picture p42: page 1]
R VERDADERO10.00; 3.65 POR TODO 8.00 1.50; ACABADO:; REBARBAR Y; ROMPER ARISTAS; NO CAMBIE LA ESCALA; REVISIÓN; ESCALA:1:2; HOJA 1 DE 1

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

NOMBRE | FIRMA | FECHA | | | | TÍTULO:

DIBUJ.
VERIF.
APROB.
FABR.
CALID. | | | | MATERIAL: | N.º DE DIBUJO Carroceria2_2 | A3

Producto SOLIDWORKS Educational. Solo para uso en la enseñanza.
