SantiagoP1405/traxxas_2026/CAD/TRAXXAS_V4/DRAW/aros_suspension.pdf

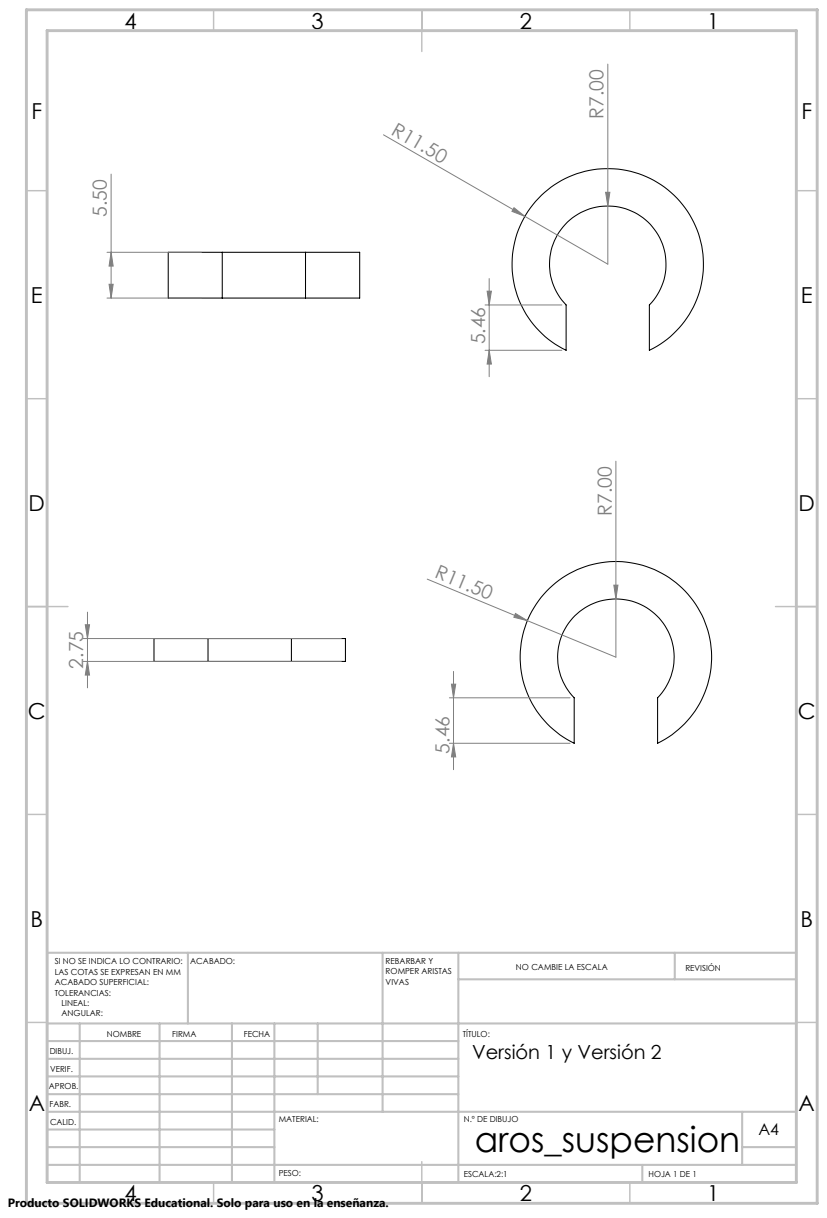
[picture p43: page 1]
ACABADO:; REBARBAR Y; ROMPER ARISTAS; NO CAMBIE LA ESCALA; REVISIÓN; ESCALA:2:1; HOJA 1 DE 1

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

NOMBRE | FIRMA | FECHA | | | | TÍTULO: Versión 1 y Versión 2

DIBUJ.
VERIF.
APROB.
FABR.
CALID. | | | | MATERIAL: | N.º DE DIBUJO aros_suspension | A4

Producto SOLIDWORKS Educational. Solo para uso en la enseñanza.
