SantiagoP1405/traxxas_2026/CAD/TRAXXAS_V4/DRAW/base_rplidar_adapter.pdf

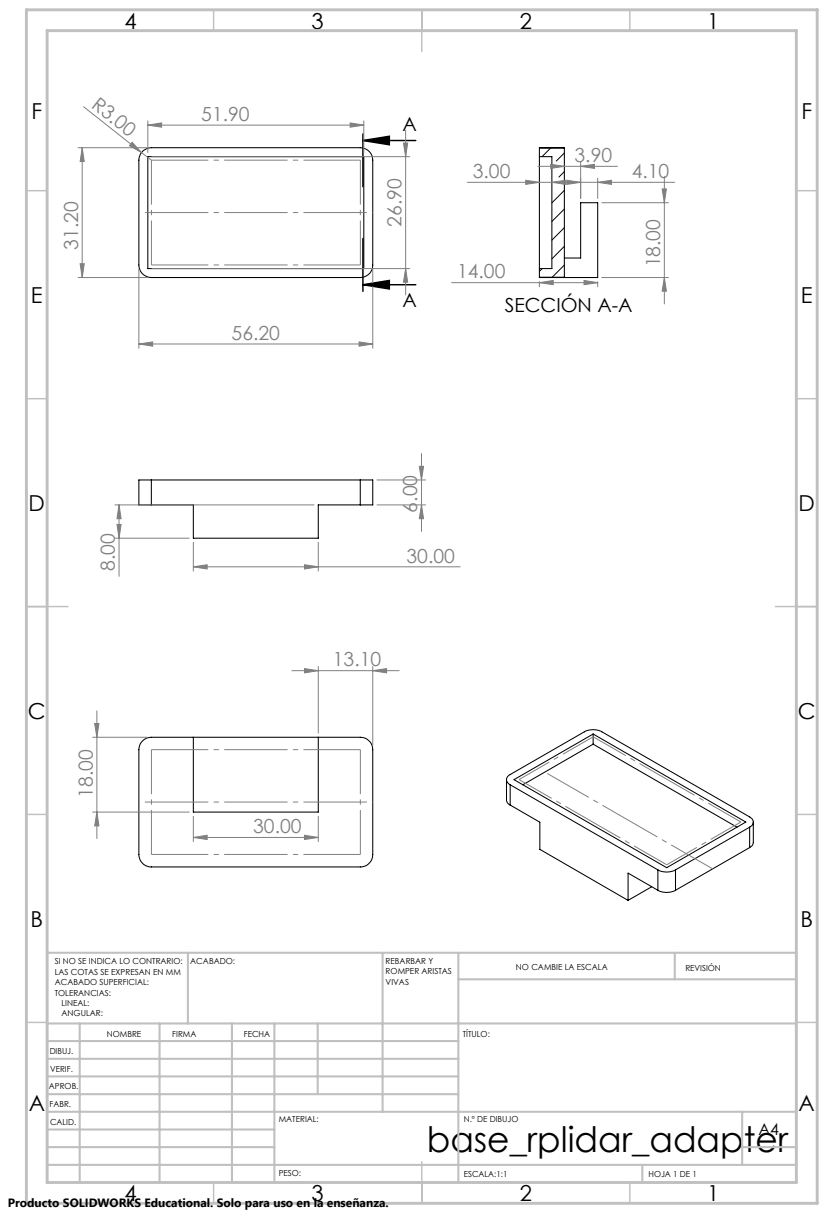
[picture p44: page 1]
SECCIÓN A-A; ACABADO:; REBARBAR Y; ROMPER ARISTAS; NO CAMBIE LA ESCALA; REVISIÓN; ESCALA:1:1; HOJA 1 DE 1

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

NOMBRE | FIRMA | FECHA | | | | TÍTULO:

DIBUJ.
VERIF.
APROB.
FABR.
CALID. | | | | MATERIAL: base_rplidar_adapter | N.º DE DIBUJO | A4

Producto SOLIDWORKS Educational. Solo para uso en la enseñanza.
