SantiagoP1405/traxxas_2026/CAD/TRAXXAS_V4/DRAW/base_ultrasonico_trasero_v3.pdf

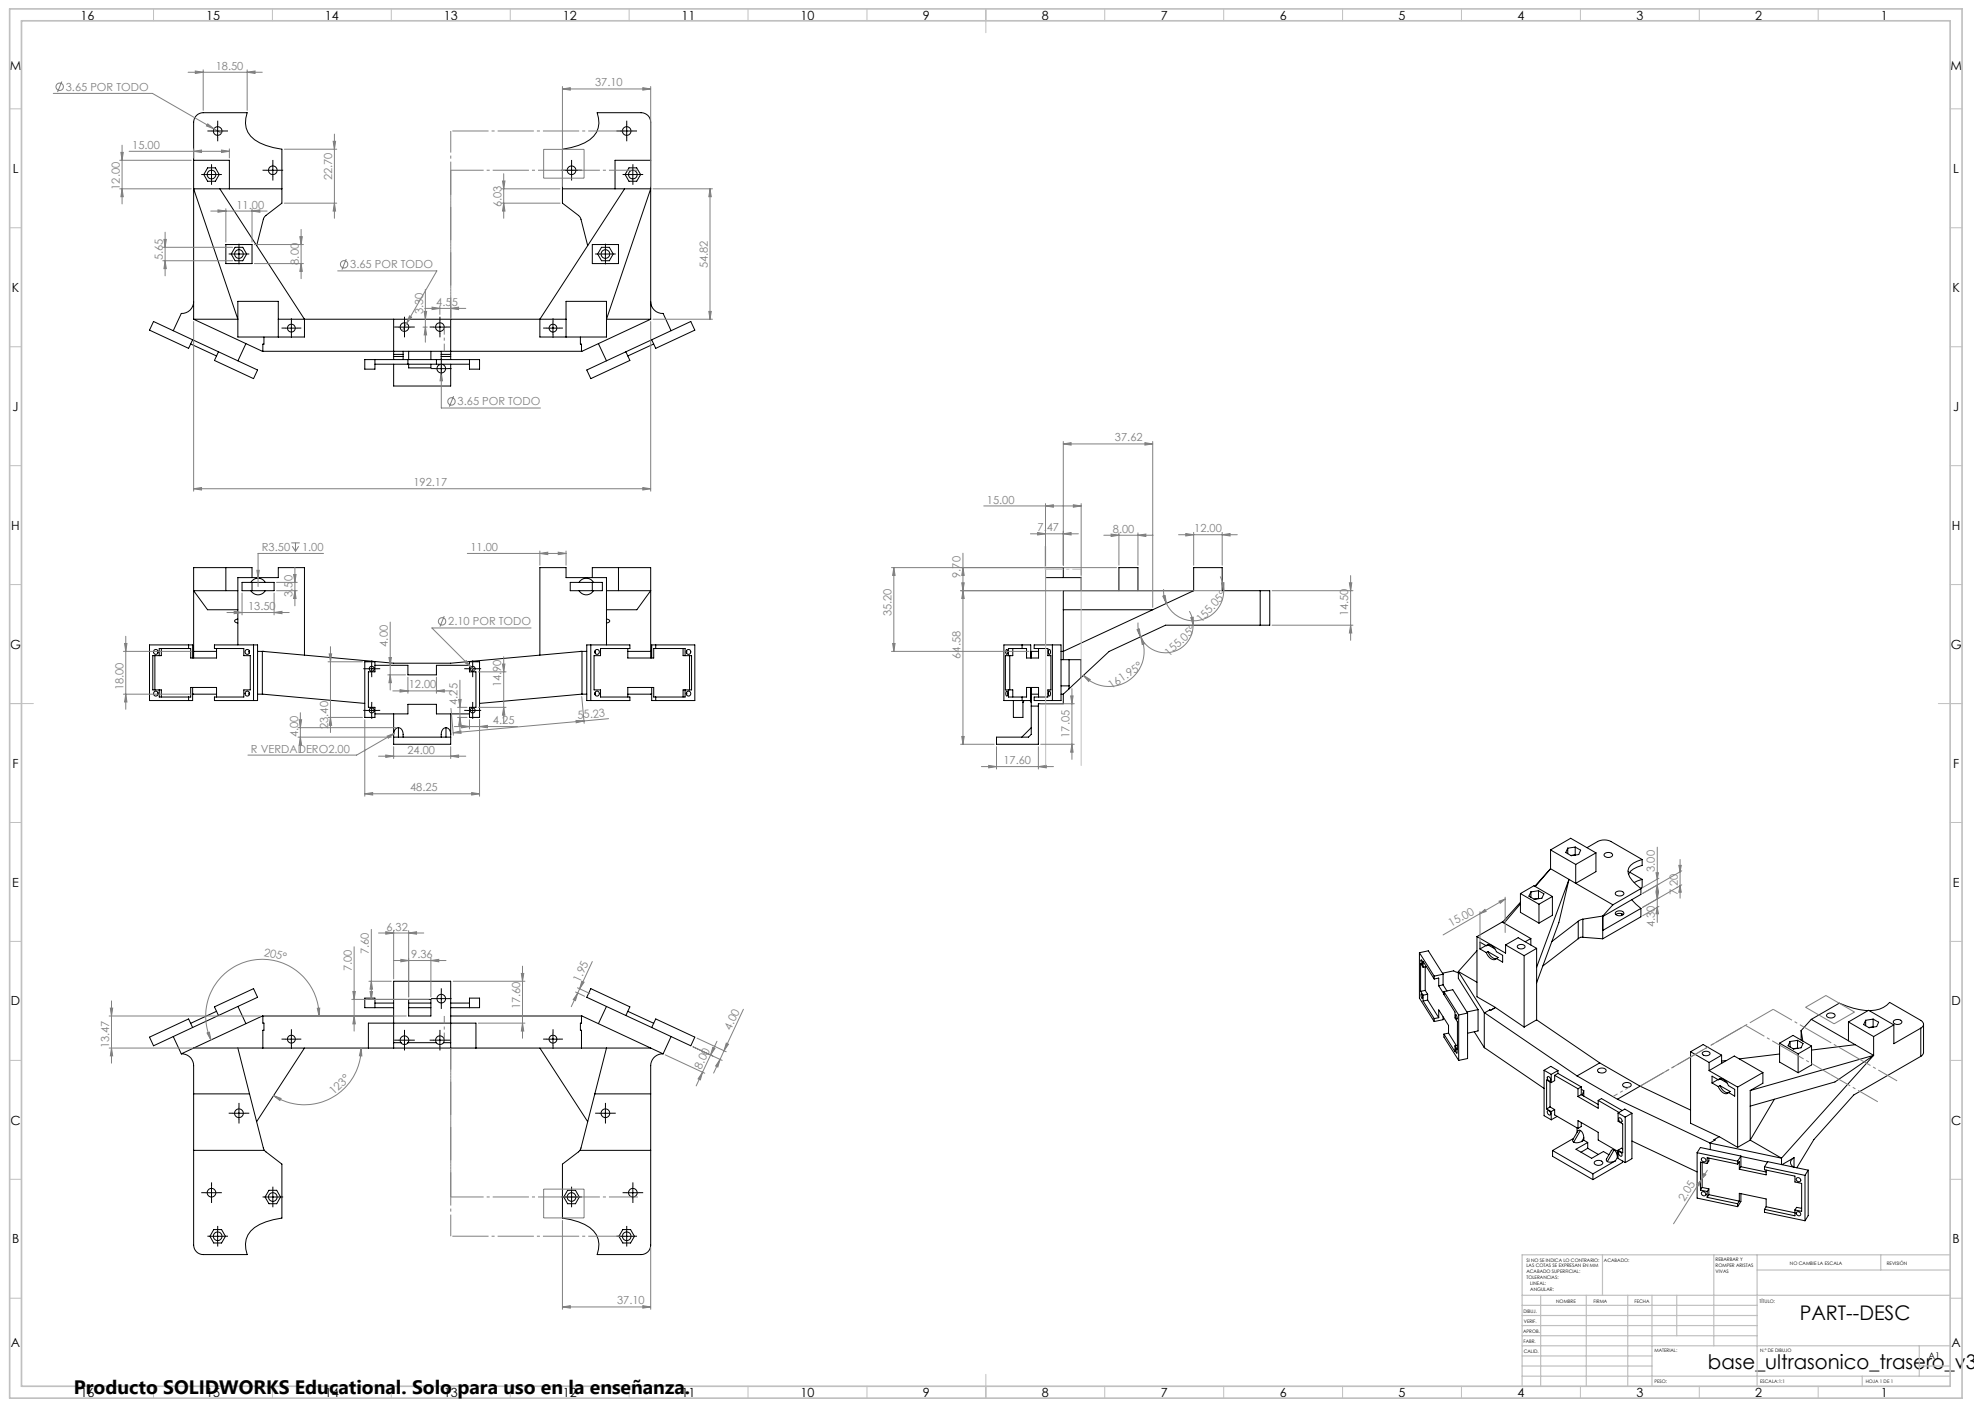
[picture p45: page 1]
2.10 POR TODO; R VERDADERO2.00 4.00; 3.65 POR TODO; ACABADO:; REBARBAR Y; ROMPER ARISTAS; NO CAMBIE LA ESCALA; REVISIÓN; ESCALA:1:1; HOJA 1 DE 1

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

NOMBRE | FIRMA | FECHA | | | | TÍTULO: PART--DESC

DIBUJ.
VERIF.
APROB.
FABR.
CALID. | | | | MATERIAL: | N.º DE DIBUJO | A1

Producto SOLIDWORKS Educational. Solo para uso en la enseñanza.
