SantiagoP1405/traxxas_2026/CAD/TRAXXAS_V4/DRAW/hexagonos_llantas.pdf

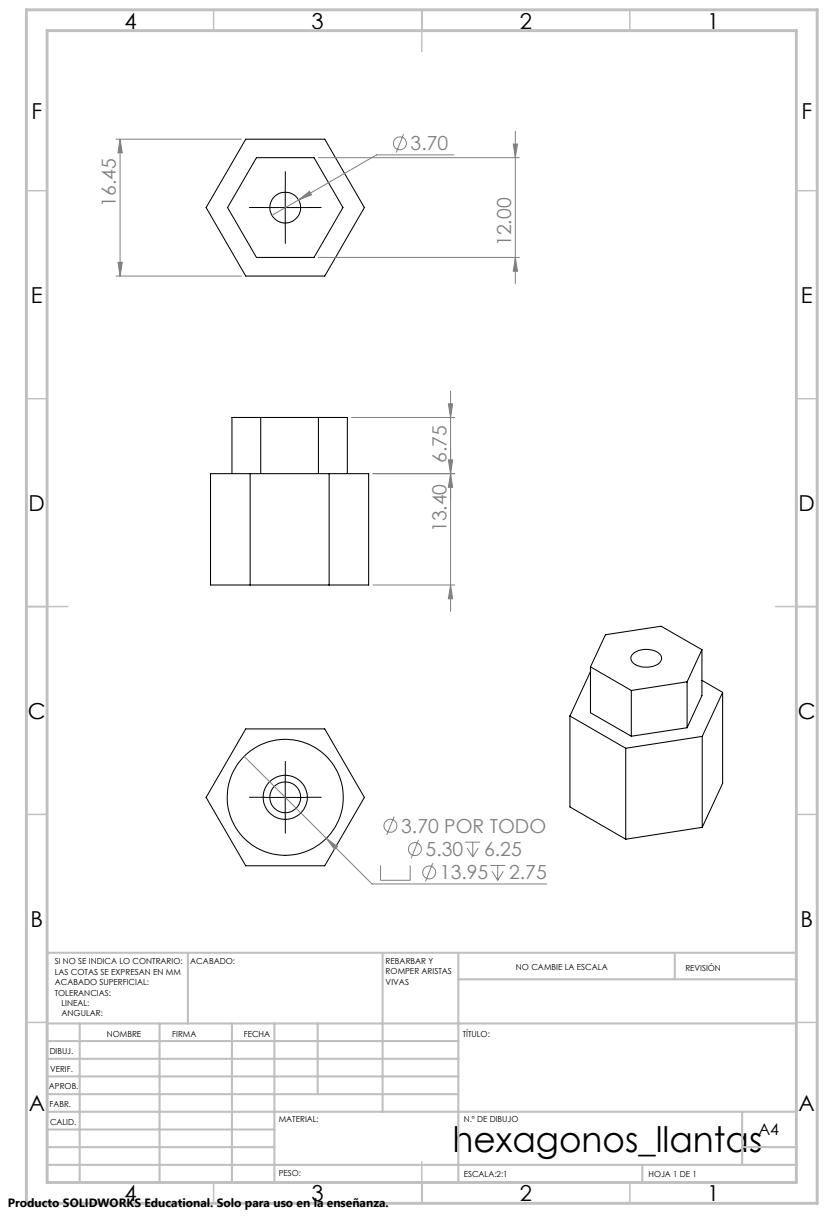
[picture p46: page 1]
3.70 POR TODO 5.30 6.25 13.95 2.75; ACABADO:; REBARBAR Y; ROMPER ARISTAS; NO CAMBIE LA ESCALA; REVISIÓN; ESCALA:2:1; HOJA 1 DE 1

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

NOMBRE | FIRMA | FECHA | | | | TÍTULO:

DIBUJ.
VERIF.
APROB.
FABR.
CALID. | | | | MATERIAL: hexagonos_llantas | N.º DE DIBUJO | A4

Producto SOLIDWORKS Educational. Solo para uso en la enseñanza.
