SantiagoP1405/traxxas_2026/CAD/TRAXXAS_V4/DRAW/primer_piso.pdf

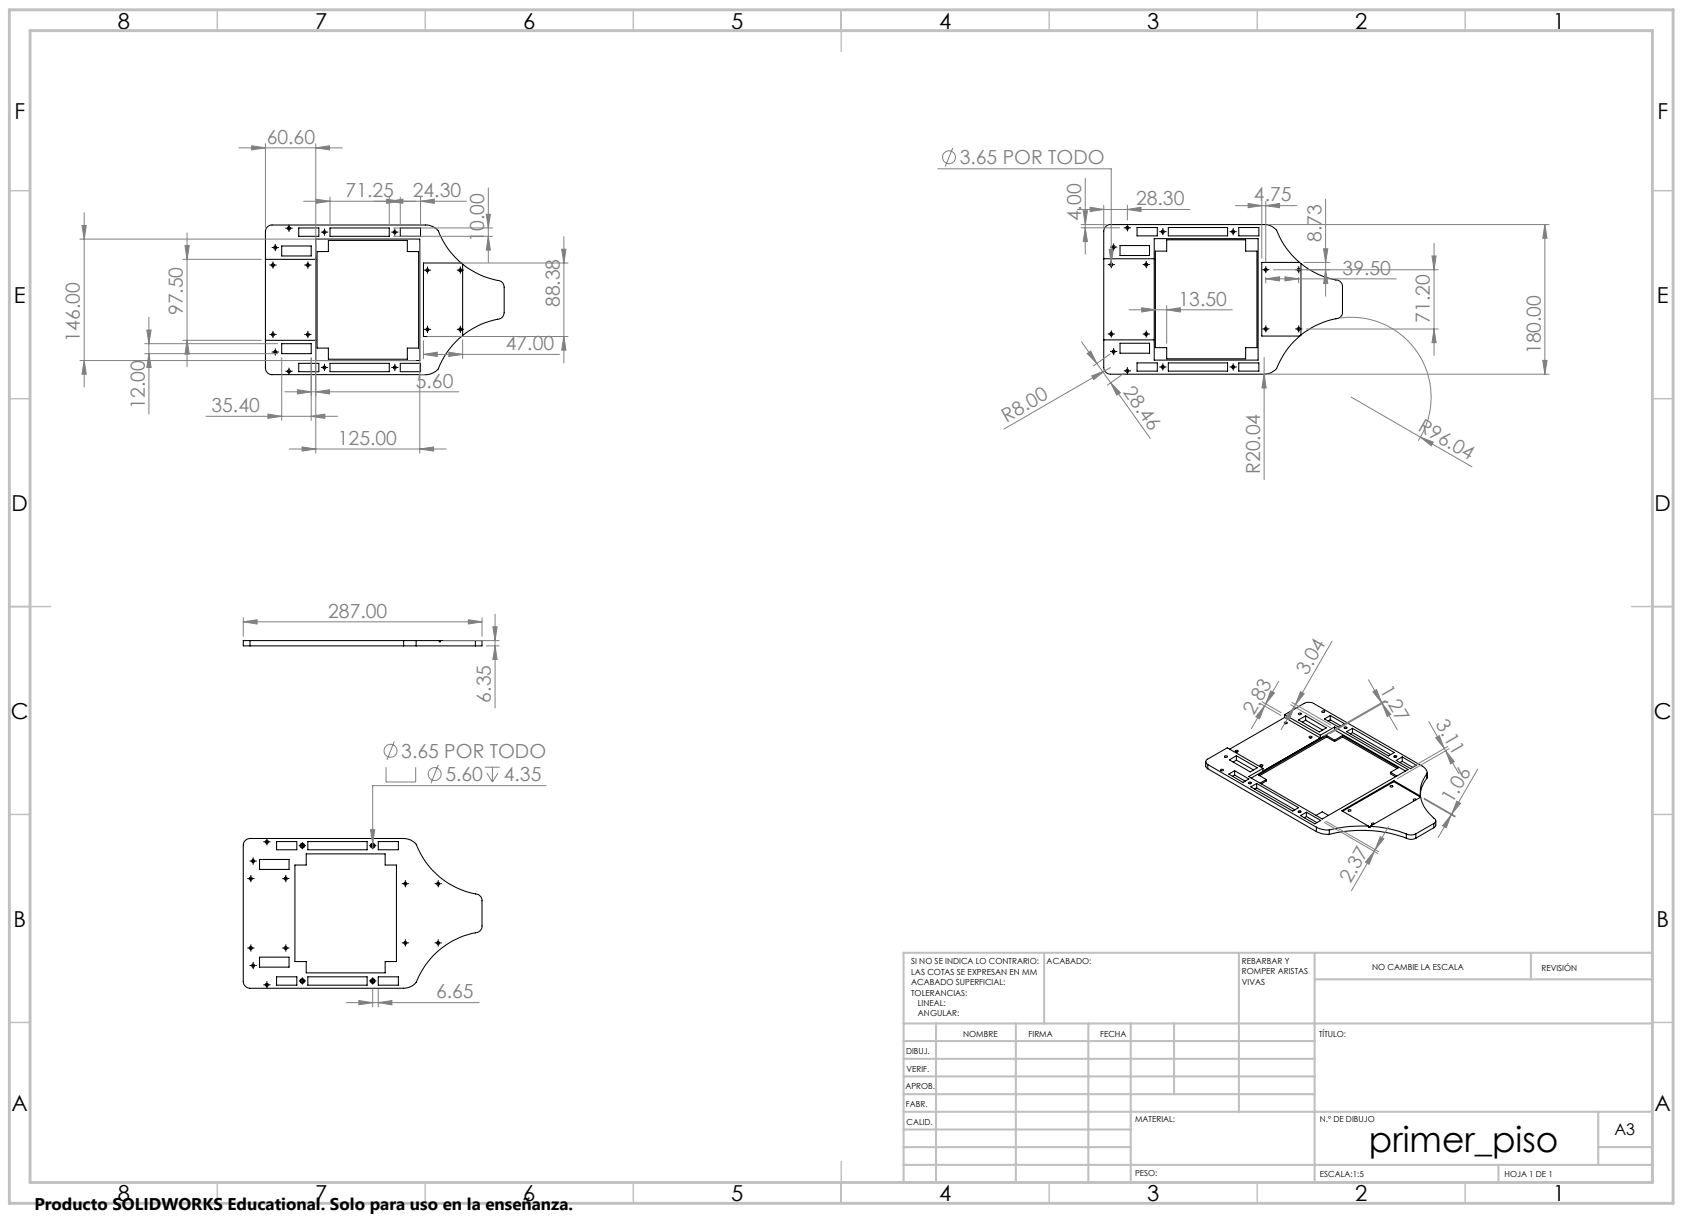
[picture p47: page 1]
3.65 POR TODO 4.00; 3.65 POR TODO 5.60 4.35; ACABADO:; REBARBAR Y; ROMPER ARISTAS; NO CAMBIE LA ESCALA; REVISIÓN; ESCALA:1:5; HOJA 1 DE 1

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

NOMBRE | FIRMA | FECHA | | | | TÍTULO:

DIBUJ.
VERIF.
APROB.
FABR.
CALID. | | | | MATERIAL: | N.º DE DIBUJO primer_piso | A3

Producto SOLIDWORKS Educational. Solo para uso en la enseñanza.
