SantiagoP1405/traxxas_2026/CAD/TRAXXAS_V4/DRAW/segundo_piso_v3_2.pdf

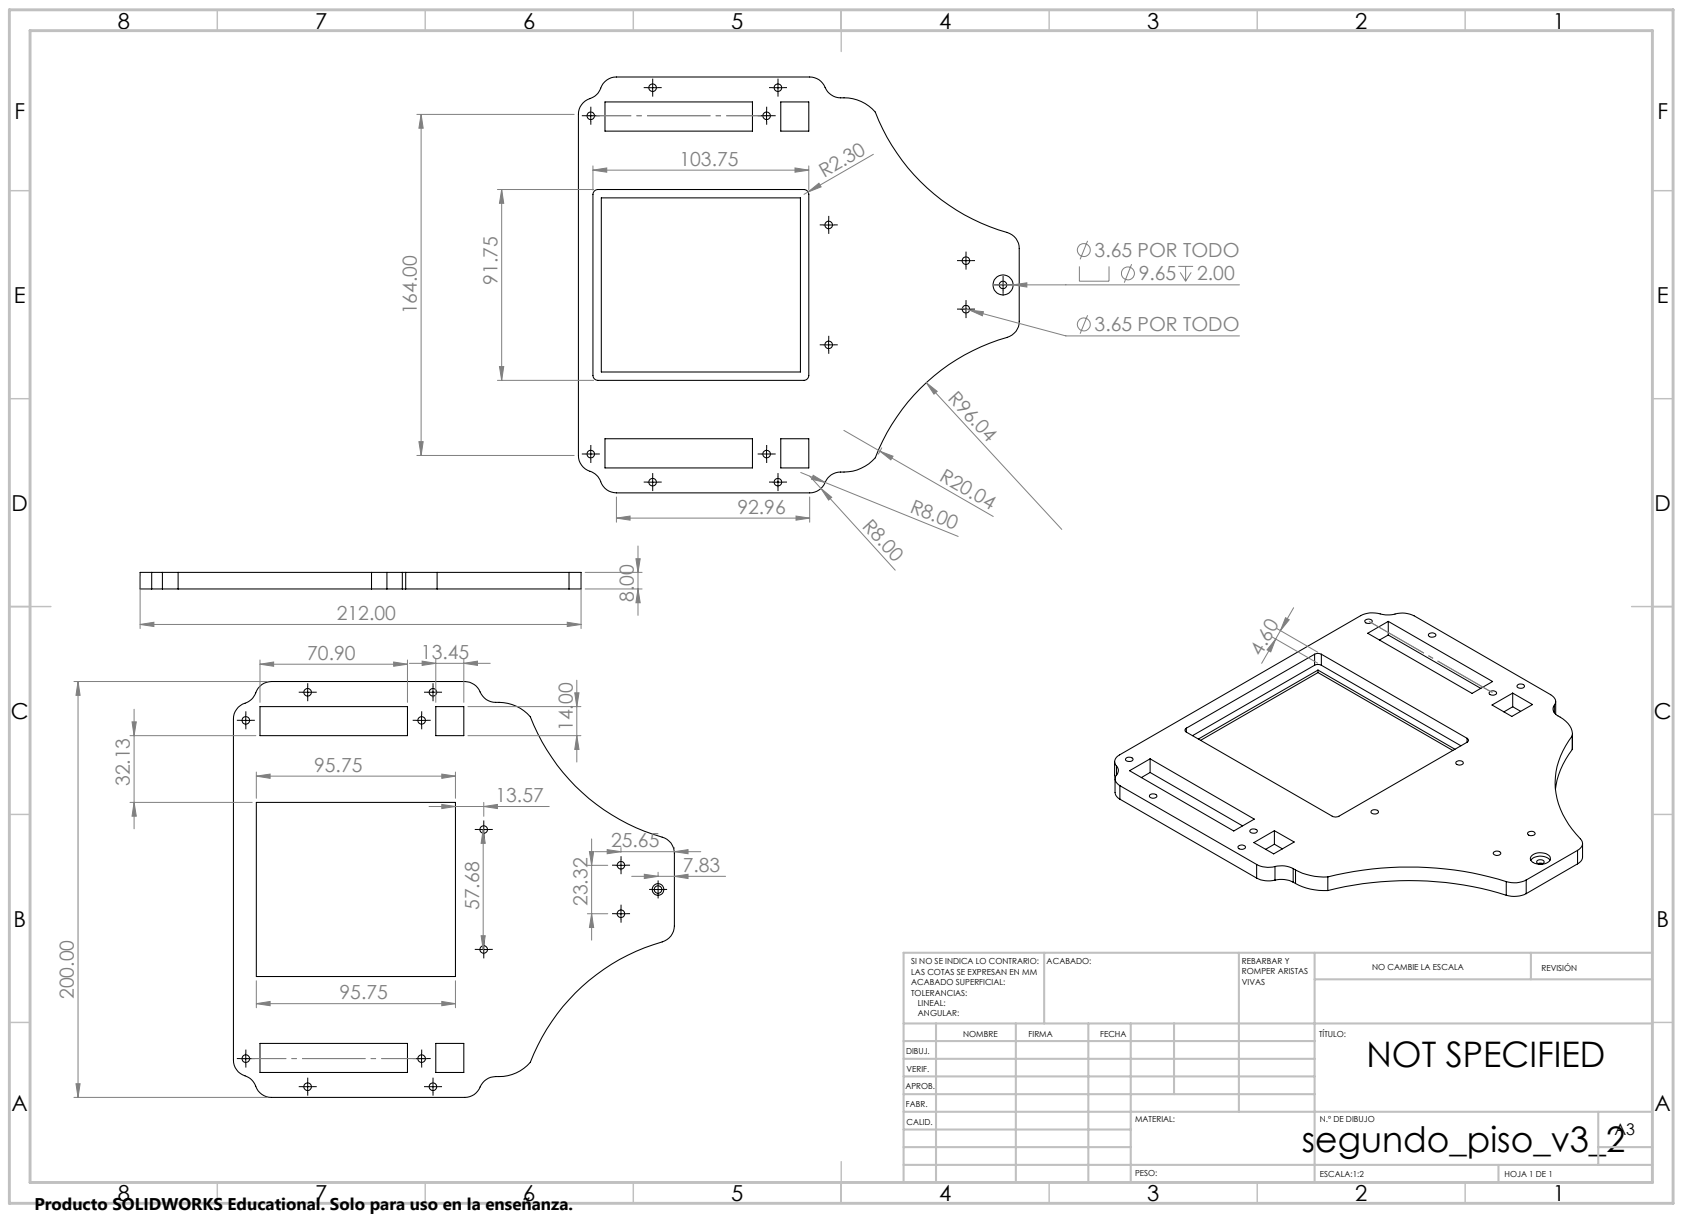
[picture p48: page 1]
3.65 POR TODO 9.65 2.00; 3.65 POR TODO; ACABADO:; REBARBAR Y; ROMPER ARISTAS; NO CAMBIE LA ESCALA; REVISIÓN; ESCALA:1:2; HOJA 1 DE 1

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

NOMBRE | FIRMA | FECHA | | | | TÍTULO: NOT SPECIFIED

DIBUJ.
VERIF.
APROB.
FABR.
CALID. | | | | MATERIAL: segundo_piso_v3_2 | N.º DE DIBUJO | A3

Producto SOLIDWORKS Educational. Solo para uso en la enseñanza.
