SantiagoP1405/traxxas_2026/CAD/TRAXXAS_V4/DRAW/separador.pdf

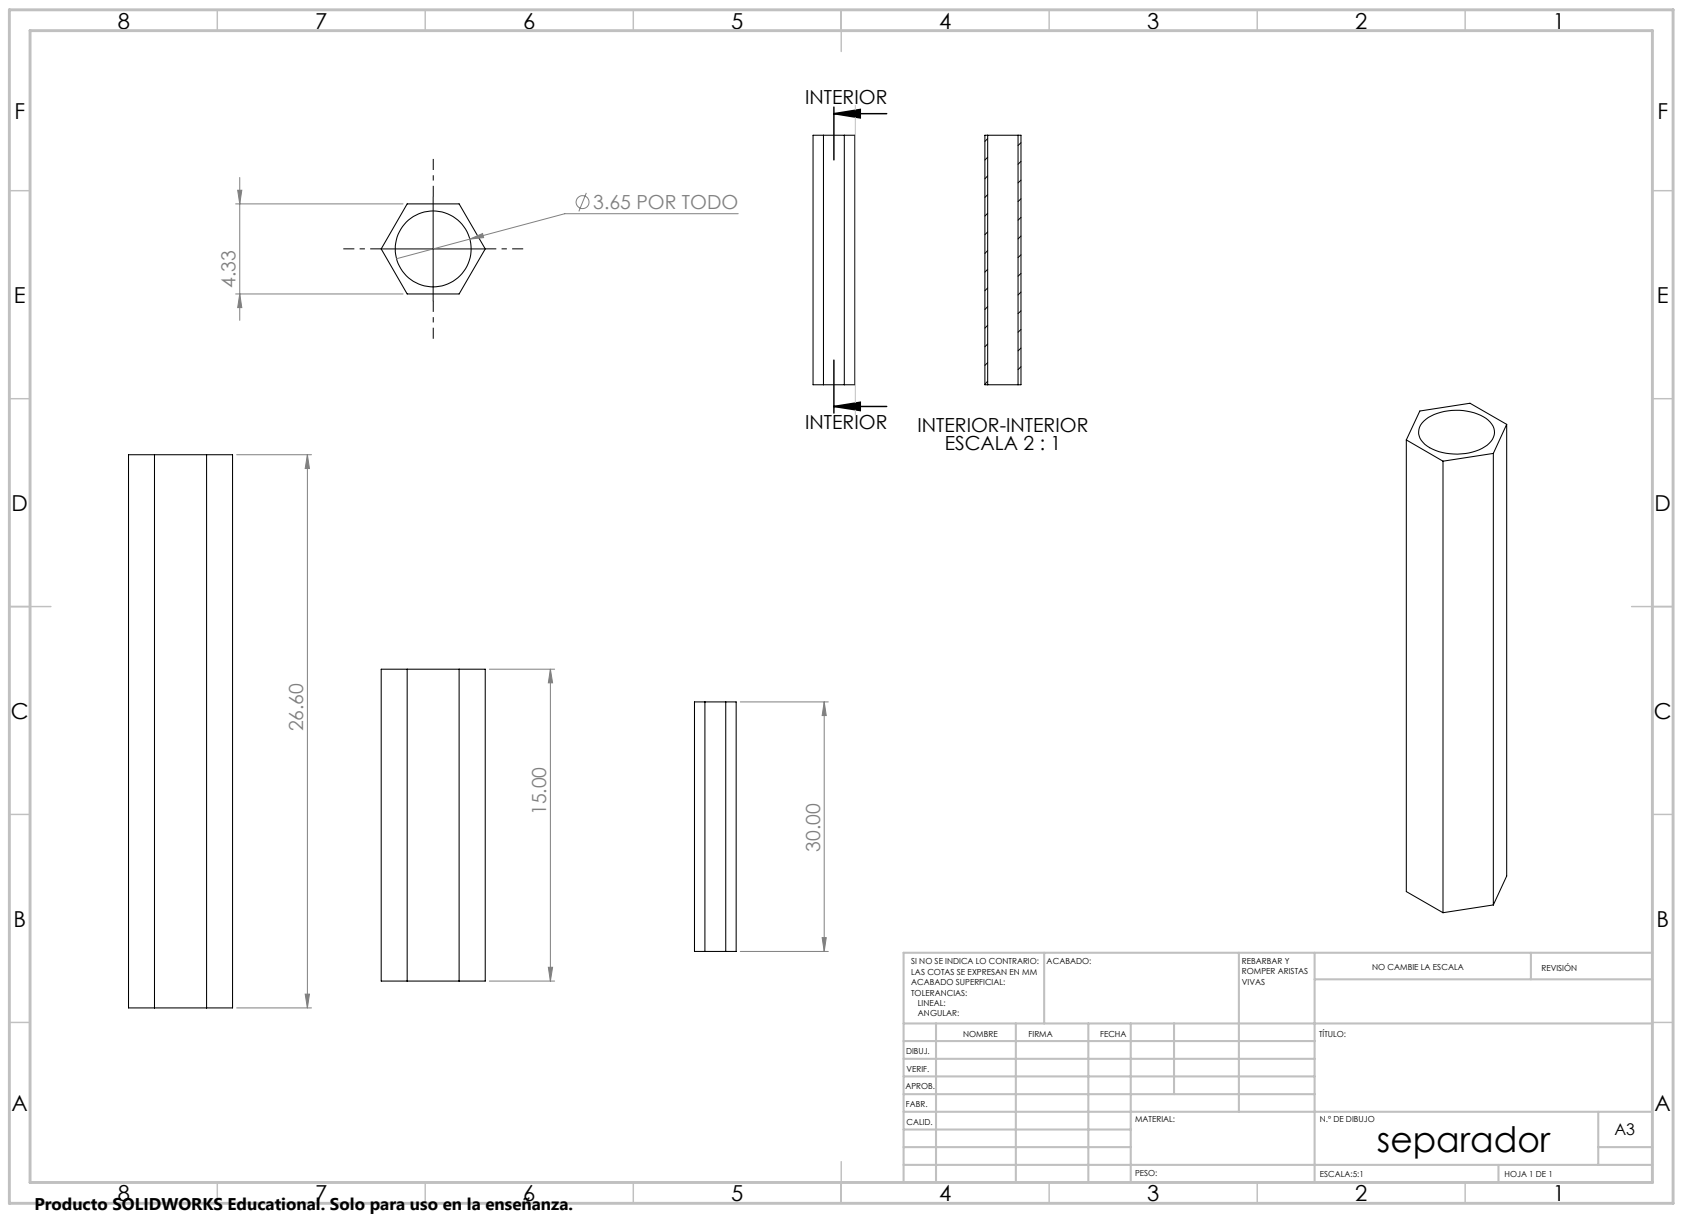
[picture p49: page 1]
3.65 POR TODO; ESCALA 2 : 1; ACABADO:; REBARBAR Y; ROMPER ARISTAS; NO CAMBIE LA ESCALA; REVISIÓN; ESCALA:5:1; HOJA 1 DE 1

INTERIOR INTERIOR-INTERIOR

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

NOMBRE | FIRMA | FECHA | | | | TÍTULO:

DIBUJ.
VERIF.
APROB.
FABR.
CALID. | | | | MATERIAL: | N.º DE DIBUJO separador | A3

Producto SOLIDWORKS Educational. Solo para uso en la enseñanza.
