SantiagoP1405/traxxas_2026/CAD/TRAXXAS_V1/DRAW/platform_deck_technical_drawing.pdf

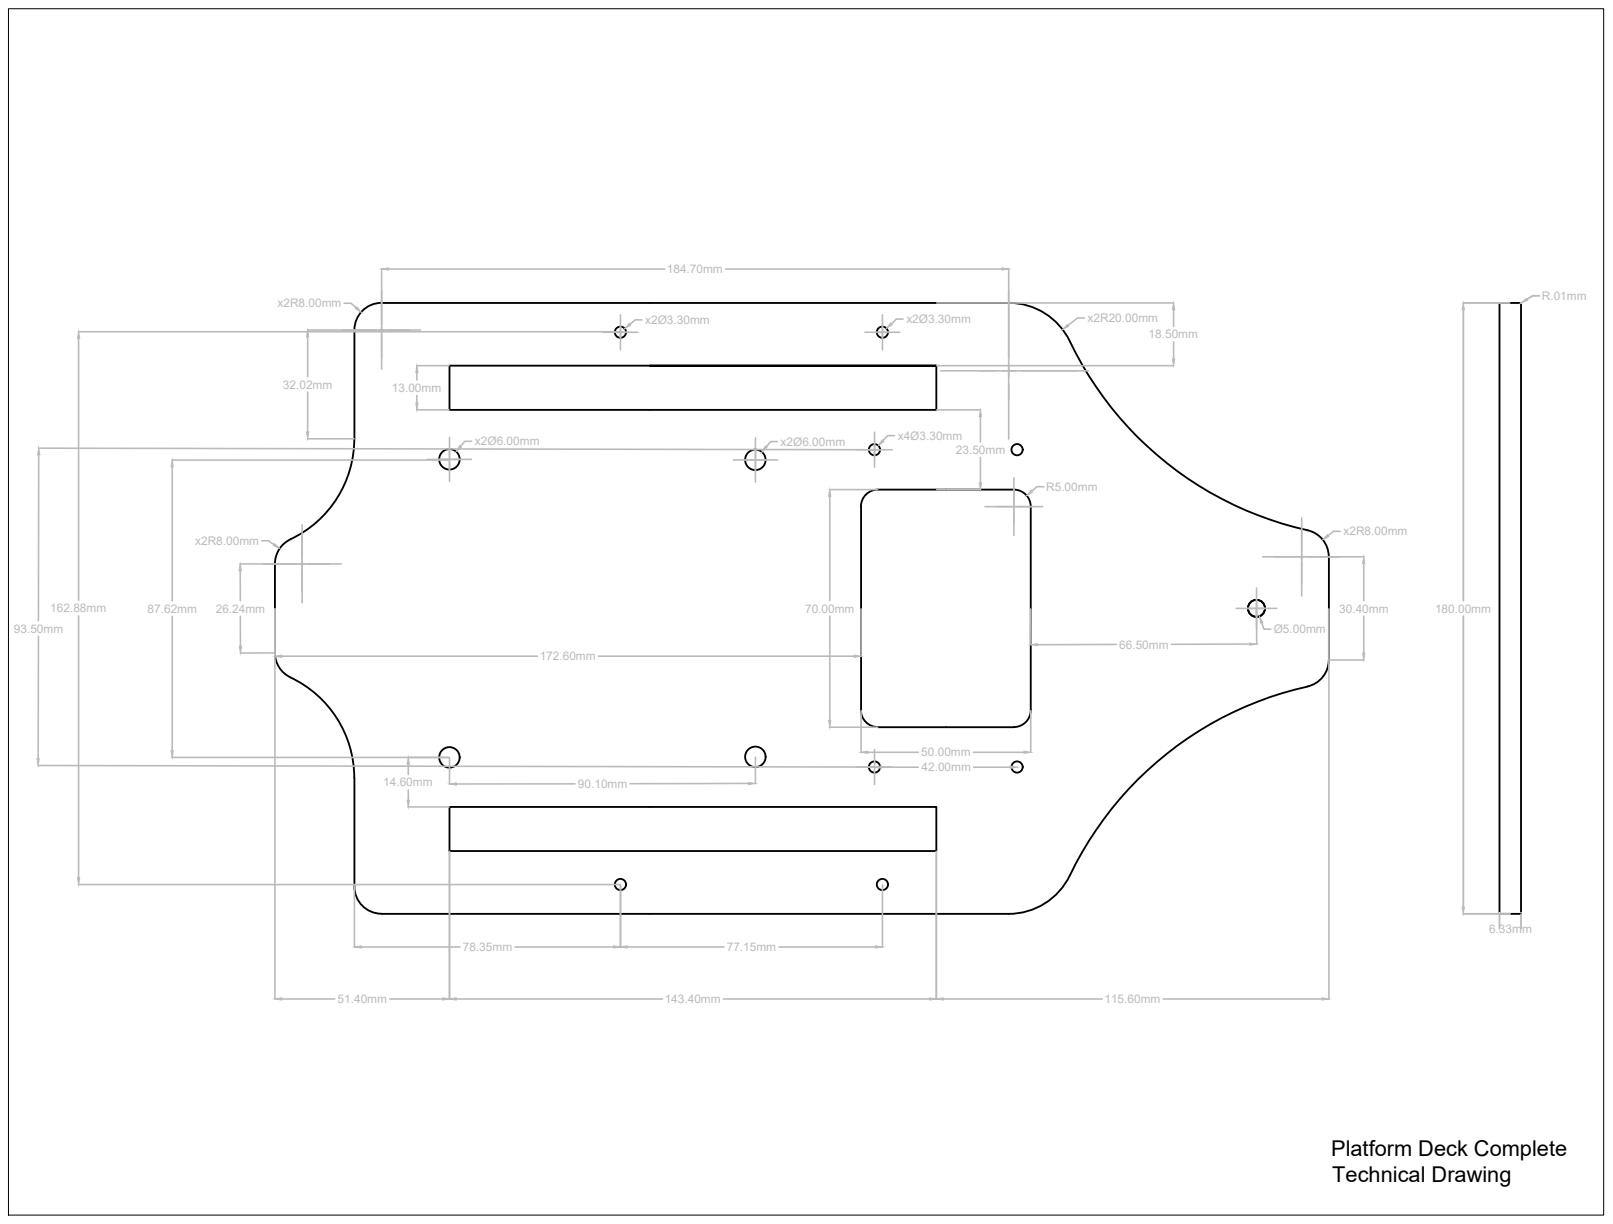
[picture p50: page 1]
R.01mm Platform Deck Complete Technical Drawing
