SantiagoP1405/traxxas_2026/CAD/TRAXXAS_V1/DRAW/platform_deck_v3_3_technical_drawing.pdf

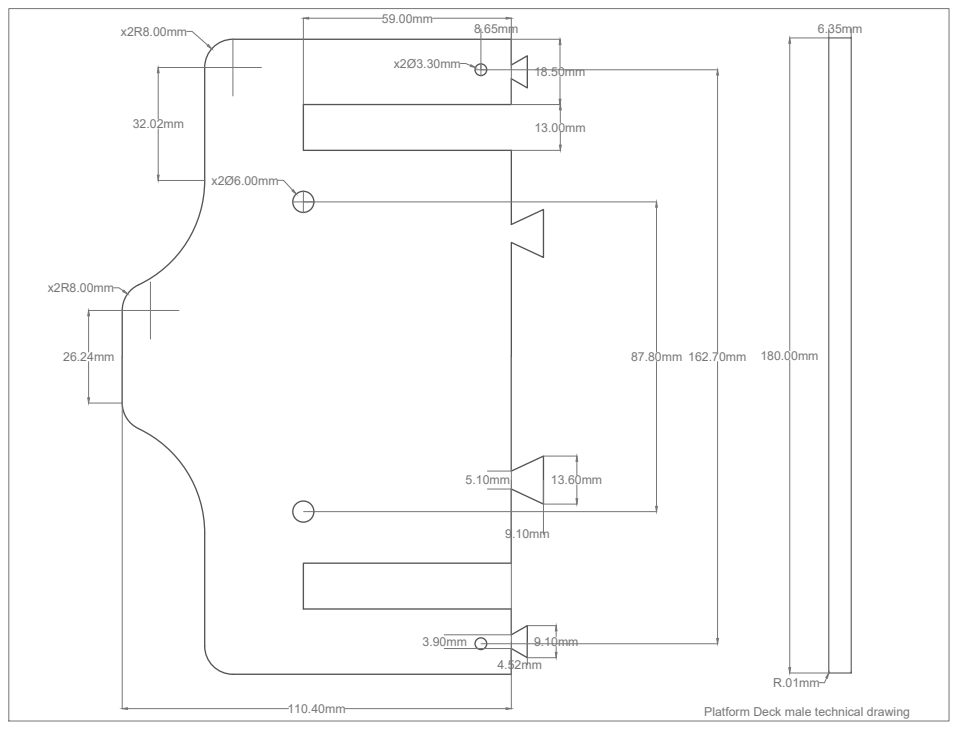
[picture p51: page 1]
6.35mm 180.00mm R.01mm Platform Deck male technical drawing
