SantiagoP1405/traxxas_2026/CAD/TRAXXAS_V1/DRAW/platform_deck_v3_2_technical_drawing.pdf

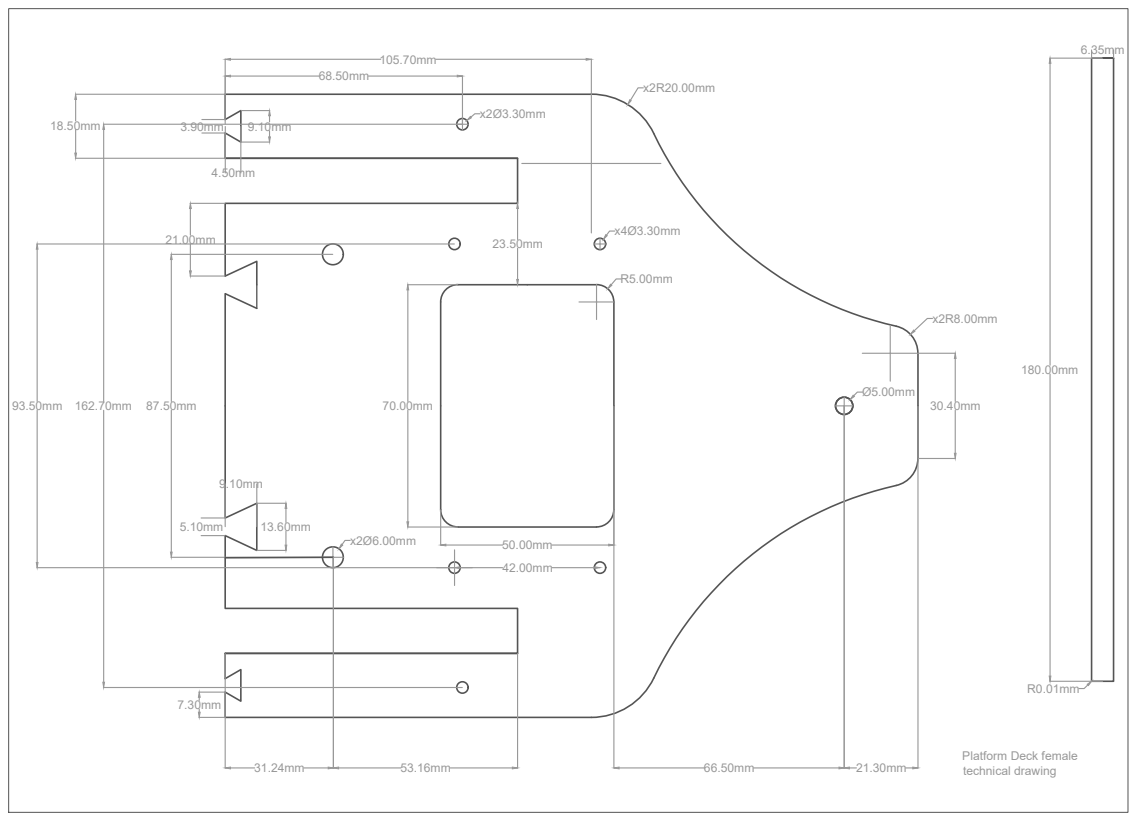
[picture p52: page 1]
Platform Deck female technical drawing
