SantiagoP1405/traxxas_2026/CIRCUITS/PCB/PCB_Master_Slaves/TMR_PCB.kicad_pcb

## KiCad design CIRCUITS/PCB/PCB_Master_Slaves/TMR_PCB.kicad_pcb (2026-01-09)

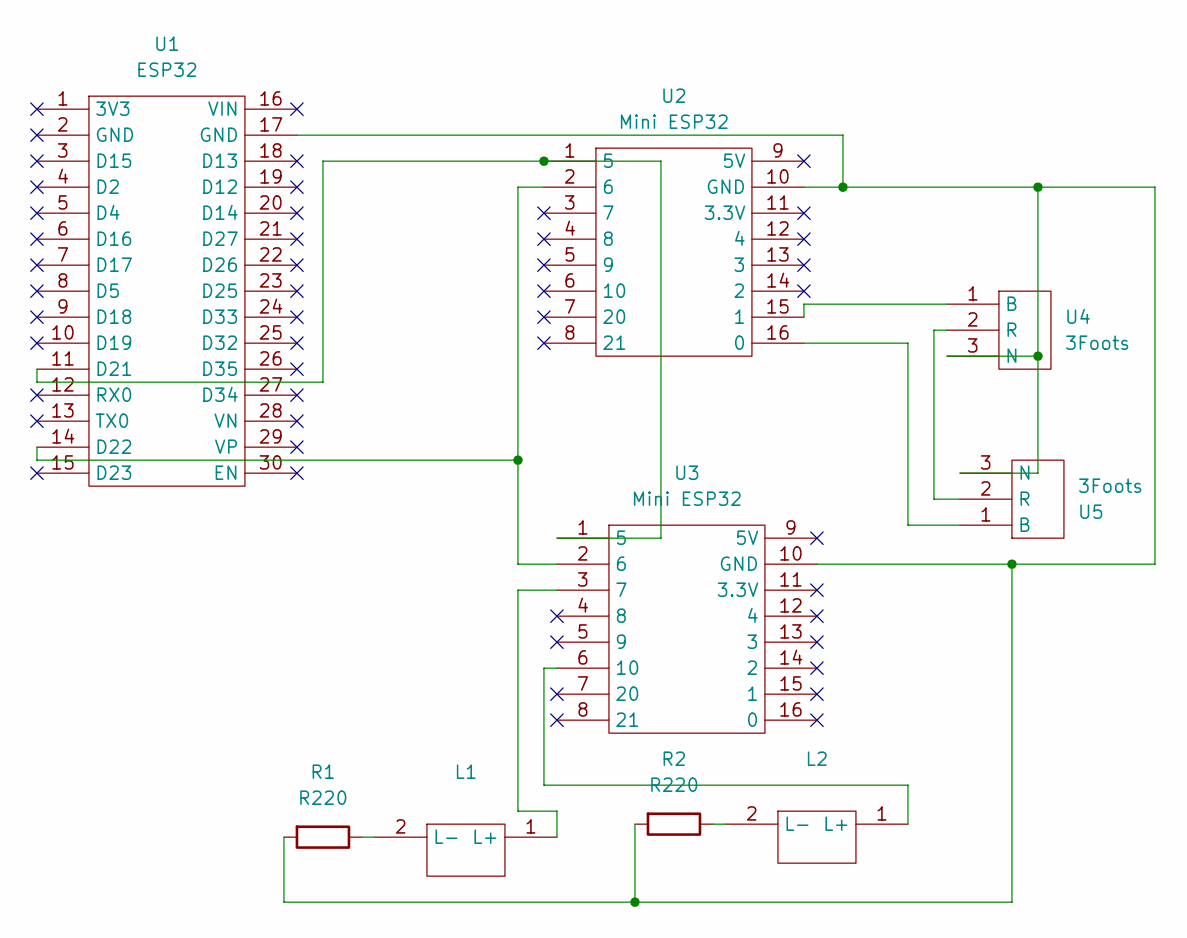
[picture p53: schematic TMR_PCB.kicad_sch]

Parts:
L1, L2: Leds
R1, R2: R220; R_Axial_DIN0207_L6.3mm_D2.5mm_P7.62mm_Horizontal
U1: ESP32
U2, U3: Mini ESP32
U4, U5: 3Foots

Connections:
unnamed: L1.1 (L+), U3.3 (7)
unnamed: L1.2 (L-), R1.1
unnamed: L2.1 (L+), U3.6 (10)
unnamed: L2.2 (L-), R2.1
unnamed: U1.11 (D21), U2.1 (5), U3.1 (5)
unnamed: U1.14 (D22), U2.2 (6), U3.2 (6)
unnamed: U2.16 (0), U5.1 (B)
unnamed: U2.15 (1), U4.1 (B)
unnamed: R1.2, R2.2, U1.17 (GND), U2.10 (GND), U3.10 (GND), U4.3 (N), U5.3 (N)
unnamed: U4.2 (R), U5.2 (R)

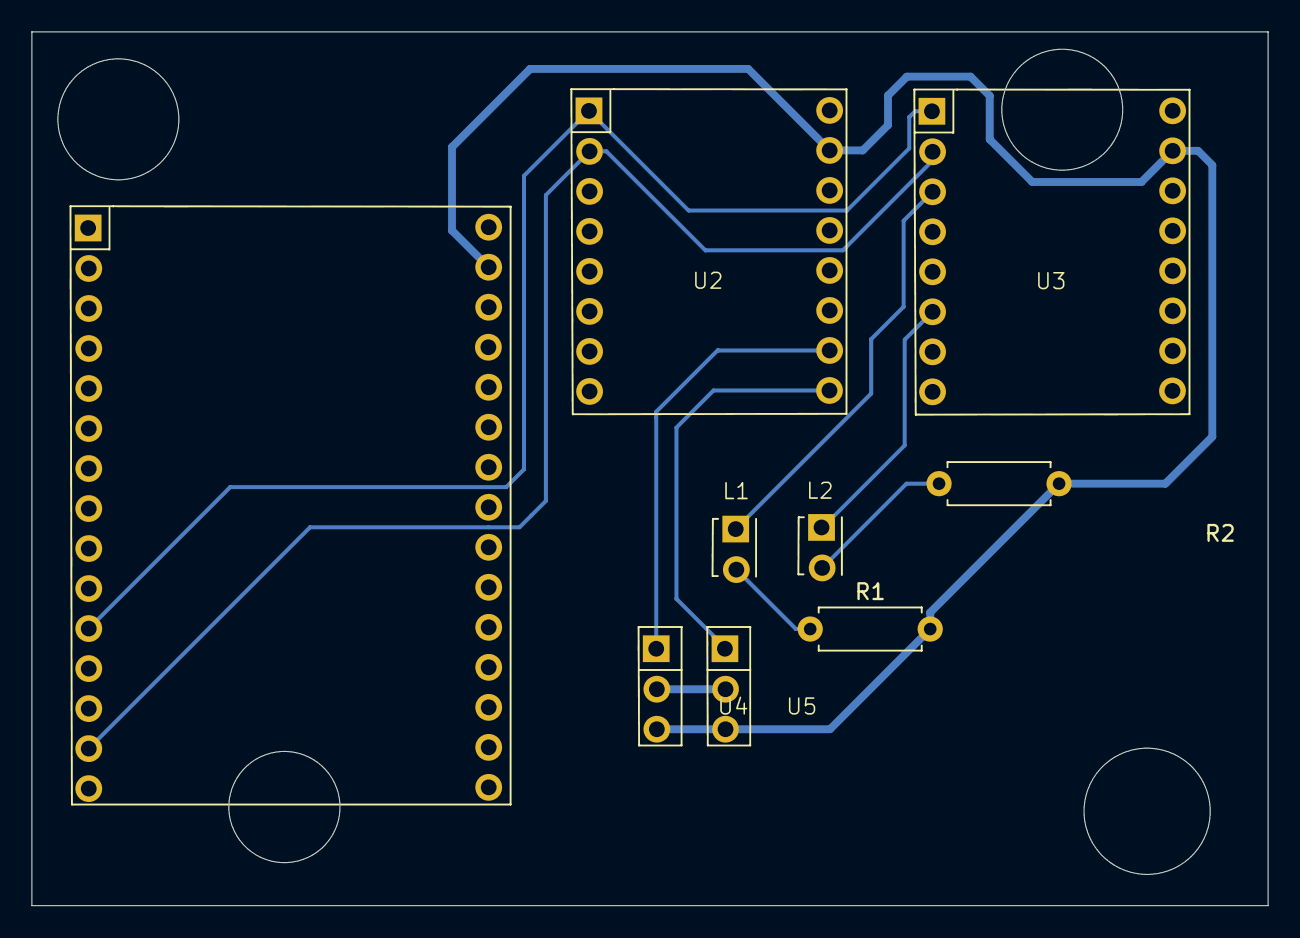
[picture p54: board TMR_PCB.kicad_pcb from above]

Board: 2 copper layers, 78.5 x 55.5 mm, 9 parts (0 on the bottom side), 10 nets.
