SantiagoP1405/traxxas_2026/traxxas_stop/traxxas_stop/stop_sign_node.py

import math
import cv2
import numpy as np
import rclpy

from rclpy.node import Node
from rclpy.qos import qos_profile_sensor_data
from cv_bridge import CvBridge
from sensor_msgs.msg import Image, CompressedImage
from std_msgs.msg import Bool, Float32
from message_filters import Subscriber, ApproximateTimeSynchronizer


class StopSignDetector(Node):
    def __init__(self):
        super().__init__('stop_sign_detector')

        self.bridge = CvBridge()

        self.declare_parameter('color_topic', '/zed/stereo/compressed')
        self.declare_parameter('depth_topic', '/zed/depth_registered')
        self.declare_parameter('min_area', 200.0)
        self.declare_parameter('debug', True)

        self.color_topic = self.get_parameter('color_topic').value
        self.depth_topic = self.get_parameter('depth_topic').value
        self.min_area = float(self.get_parameter('min_area').value)
        self.debug_enabled = bool(self.get_parameter('debug').value)

        self.pub_detected_raw = self.create_publisher(Bool, '/traxxas/stop_sign/detected_raw', 10)
        self.pub_distance = self.create_publisher(Float32, '/traxxas/stop_sign/distance_m', 10)
        self.pub_area = self.create_publisher(Float32, '/traxxas/stop_sign/area', 10)
        self.pub_debug = self.create_publisher(Image, '/traxxas/stop_sign/debug_image', 10)

        # Ahora color es CompressedImage
        self.color_sub = Subscriber(self, CompressedImage, self.color_topic, qos_profile=qos_profile_sensor_data)
        self.depth_sub = Subscriber(self, Image, self.depth_topic, qos_profile=qos_profile_sensor_data)

        self.sync = ApproximateTimeSynchronizer(
            [self.color_sub, self.depth_sub],
            queue_size=10,
            slop=0.1
        )
        self.sync.registerCallback(self.synced_callback)

        self.get_logger().info(f'Color topic: {self.color_topic}')
        self.get_logger().info(f'Depth topic: {self.depth_topic}')

    def detect_stop_sign(self, frame):
        debug = frame.copy()

        blurred = cv2.GaussianBlur(frame, (5, 5), 0)
        hsv = cv2.cvtColor(blurred, cv2.COLOR_BGR2HSV)

        lower_red1 = np.array([0, 60, 40])
        upper_red1 = np.array([10, 255, 255])

        lower_red2 = np.array([170, 60, 40])
        upper_red2 = np.array([180, 255, 255])

        mask1 = cv2.inRange(hsv, lower_red1, upper_red1)
        mask2 = cv2.inRange(hsv, lower_red2, upper_red2)
        mask = cv2.bitwise_or(mask1, mask2)

        kernel = np.ones((3, 3), np.uint8)
        mask = cv2.morphologyEx(mask, cv2.MORPH_OPEN, kernel)
        mask = cv2.morphologyEx(mask, cv2.MORPH_CLOSE, kernel)

        contours, _ = cv2.findContours(mask, cv2.RETR_EXTERNAL, cv2.CHAIN_APPROX_SIMPLE)

        best = None
        best_area = 0.0

        for cnt in contours:
            area = cv2.contourArea(cnt)
            if area < self.min_area:
                continue

            perimeter = cv2.arcLength(cnt, True)
            if perimeter == 0:
                continue

            approx = cv2.approxPolyDP(cnt, 0.015 * perimeter, True)
            sides = len(approx)

            if sides < 5 or sides > 10:
                continue

            if not cv2.isContourConvex(approx):
                continue

            x, y, w, h = cv2.boundingRect(approx)
            aspect_ratio = w / float(h)

            if aspect_ratio < 0.75 or aspect_ratio > 1.25:
                continue

            rect_area = w * h
            fill_ratio = area / float(rect_area + 1e-6)

            if fill_ratio < 0.55:
                continue

            if area > best_area:
                cx = x + w // 2
                cy = y + h // 2
                best_area = area
                best = {
                    'approx': approx,
                    'x': x, 'y': y, 'w': w, 'h': h,
                    'cx': cx, 'cy': cy,
                    'area': float(area),
                    'sides': sides
                }

        if best is None:
            cv2.putText(
                debug,
                'No stop sign detected',
                (20, 40),
                cv2.FONT_HERSHEY_SIMPLEX,
                0.9,
                (0, 0, 255),
                2
            )
            return False, debug, mask, None

        cv2.drawContours(debug, [best['approx']], -1, (0, 255, 0), 3)
        cv2.rectangle(
            debug,
            (best['x'], best['y']),
            (best['x'] + best['w'], best['y'] + best['h']),
            (255, 0, 0),
            2
        )
        cv2.circle(debug, (best['cx'], best['cy']), 5, (0, 255, 255), -1)

        cv2.putText(
            debug,
            f"STOP detected | area={int(best['area'])} | sides={best['sides']}",
            (best['x'], max(30, best['y'] - 10)),
            cv2.FONT_HERSHEY_SIMPLEX,
            0.7,
            (0, 255, 0),
            2
        )

        return True, debug, mask, best

    def get_depth_at_center(self, depth_img, cx: int, cy: int) -> float:
        h, w = depth_img.shape[:2]

        if not (0 <= cx < w and 0 <= cy < h):
            return float('nan')

        x0 = max(0, cx - 2)
        x1 = min(w, cx + 3)
        y0 = max(0, cy - 2)
        y1 = min(h, cy + 3)

        patch = depth_img[y0:y1, x0:x1]

        valid = patch[np.isfinite(patch)]
        valid = valid[valid > 0.0]

        return float(np.median(valid)) if valid.size > 0 else float('nan')

    def decode_left_from_stereo(self, compressed_msg):
        np_arr = np.frombuffer(compressed_msg.data, np.uint8)
        stereo = cv2.imdecode(np_arr, cv2.IMREAD_COLOR)

        if stereo is None:
            raise ValueError("No se pudo decodificar la imagen JPEG")

        h, w, _ = stereo.shape
        mid = w // 2

        # Tomar la mitad izquierda del frame estéreo
        left = stereo[:, :mid, :]
        return left

    def synced_callback(self, color_msg, depth_msg):
        try:
            frame = self.decode_left_from_stereo(color_msg)
        except Exception as e:
            self.get_logger().error(f'Error convirtiendo imagen comprimida: {e}')
            return

        try:
            depth = self.bridge.imgmsg_to_cv2(depth_msg, desired_encoding='passthrough')
        except Exception as e:
            self.get_logger().error(f'Error convirtiendo profundidad: {e}')
            return

        detected, debug, mask, best = self.detect_stop_sign(frame)

        raw_msg = Bool()
        raw_msg.data = detected
        self.pub_detected_raw.publish(raw_msg)

        area_msg = Float32()
        dist_msg = Float32()

        if detected and best is not None:
            distance_m = self.get_depth_at_center(depth, best['cx'], best['cy'])
            area_msg.data = float(best['area'])
            dist_msg.data = distance_m if math.isfinite(distance_m) else -1.0

            dist_text = (
                f"dist={distance_m:.2f} m"
                if math.isfinite(distance_m) else
                "dist=invalid"
            )

            cv2.putText(
                debug,
                dist_text,
                (best['x'], best['y'] + best['h'] + 25),
                cv2.FONT_HERSHEY_SIMPLEX,
                0.7,
                (255, 255, 0),
                2
            )
        else:
            area_msg.data = 0.0
            dist_msg.data = -1.0

        self.pub_area.publish(area_msg)
        self.pub_distance.publish(dist_msg)

        if self.debug_enabled:
            try:
                dbg_msg = self.bridge.cv2_to_imgmsg(debug, encoding='bgr8')
                dbg_msg.header = depth_msg.header
                self.pub_debug.publish(dbg_msg)
            except Exception as e:
                self.get_logger().error(f'Error publicando debug image: {e}')


def main(args=None):
    rclpy.init(args=args)
    node = StopSignDetector()
    try:
        rclpy.spin(node)
    except KeyboardInterrupt:
        pass
    node.destroy_node()
    rclpy.shutdown()


if __name__ == '__main__':
    main()
