SantiagoP1405/traxxas_2026/(commit log)

2025-12-15 Traxxas Motor Controler - Standalone Version
    ENG
    - micro-ROS code to control the steering servo and the Traxxas drive motor using 16-bit PWM signals at 100 Hz with a single ESP32.
    - Configuration of two PWM channels (ESP32 LEDC) for motor control:
    - PWM_R_CHANNEL (pin 23): Right motor (throttle)
    - PWM_L_CHANNEL (pin 18): Left motor (steering)
    - Frequency: 100 Hz, Resolution: 16 bits
    - Implementation of a subscription system to three ROS 2 topics:
    - 'led_power': LED mode control (R/L/F/S)
    - 'throttle_motor': Right motor PWM control (0–65535)
    - 'direction_servo': Left motor PWM control (0–65535)
    - Addition of an LED indicator system with synchronized blinking:
    - LED_PIN_R (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
2025-12-15 Traxxas Master Control I2C
2026-01-07 CIRCUITS
    - Created circuits folder to store circuit diagrams and PCBs
    - Added diagram for the micro-ROS circuit
    ESP
    - Creada la carpeta para almacenar digramas de circuitos y PCBs.
    - Añadido diagramas para la red de micro-ROS
    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
2026-01-09 PCB para lo de Pato y Dario
    [TMR_PCB.kicad_pcb, TMR_PCB.kicad_sch]
2026-01-15 ADD traxxas_robot_description
    - Created ROS2 package for robot description for simulations
    - Creado nuevo paquete de ROS2 para la descripción del robot para simulaciones
    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
2026-01-17 Traxxas urdf.xacro
    - Added common properties XACRO file with material definitions (blue, green, grey, black, grey_dark) and inertia calculation macros for box, sphere, and cylinder shapes to standardize physical properties across robot components.
    - Implemented mobile base XACRO file defining chassis link with dimensions (length: 0.31m, width: 0.18m, height: 0.062m), mass calculated from density, and visual/collision geometries using box shape.
    - Included front and rear suspension links with specific dimensions, masses, and box geometries for realistic vehicle dynamics.
    - Defined wheel properties including radius (0.0535m), width (0.045m), density (900.0 kg/m³), and calculated mass usin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
    [common_properties.xacro, mobile_base.xacro, traxxas.urdf.xacro]
2026-01-17 Corrected Mobile Base
    - Corrected invalid parameter values
    - Corregidos parámetros con valores inválidos
    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
    [mobile_base.xacro]
2026-01-17 RVIZ2 config
    - Added configuration file for RViz2 visualization
    - Añadido archivo de configuración para visualización en RViz2
    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
2026-01-17 robot description - launch file
    - Added ROS2 launch file display.launch.py for visualizing the Traxxas robot model in RViz, enabling interactive inspection of the robot's URDF structure and joint states.
    - Imported essential launch modules including LaunchDescription, Node, ParameterValue, Command, and Substitutions to handle dynamic parameter loading and command execution.
    - Utilized ament_index_python.packages.get_package_share_path to dynamically locate package share directories, ensuring portability across different ROS2 workspaces.
    - Defined paths for the XACRO URDF file (traxxas.urdf.xacro) and RViz configuration file (config.rviz) within the traxxas_robot_description package for o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
2026-01-19 UPDATE steering
    - Update in steering angles.
    - Actualizado el ángulo de giro del volante.
    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
    [mobile_base.xacro]
2026-01-19 Implemented Gazebo plugins
    - Added friction parameters (mu1, mu2) for all wheel links
    to enable realistic wheel-surface interactions in simulation
    - Integrated `gz-sim-ackermann-steering-system` plugin
    to simulate realistic Ackermann steering geometry with configurable steering limits and
    velocity constraints
    - Added JointStatePublisher plugin to publish real-time
    joint states for steering and wheel joints at 50Hz
    - Organized robot description into separate xacro files
    (common_properties, mobile_base, mobile_base_gazebo) for better maintainability
    - Configured odometry feedback from Ackermann steering system
    with proper frame hierarchy
    - Se agregaron parámetros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
    [mobile_base_gazebo.xacro, traxxas.urdf.xacro]
2026-01-19 fixed ackermann_steering plugin parameter
    [mobile_base_gazebo.xacro]
2026-01-19 Traxxas Gazebo
    - Created ROS2 package for the gazebo simulation of the Traxxas robot
    - Add robot simulation launch file (gz_sim.launch.py) that configures the complete simulation pipeline
    - Integrate ROS 2 with Gazebo Ignition through robot_state_publisher for kinematic chain updates
    Include spawn mechanism for robot model in Gazebo environment using robot description
    - Configure ros_gz_bridge with parameter-based bridge configuration for topic mapping
    - Add Rviz2 visualization node with simulation time synchronization
    - Create bridge configuration file (gz_bridge.yaml) defining bidirectional communication between ROS and Gazebo
    - Map critical topics including clock, joint states, transf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
2026-01-19 Title: Lane dectector Node
    Current features:
    - Real-time camera capture using OpenCV
    - ROI masking and perspective transform (bird's-eye view)
    - Sliding window lane detection
    - Polynomial lane fitting
    - Curvature estimation
    - Steering angle computation using vehicle kinematics
    - Conversion from steering angle to PWM output
    - ROS2 publishers for steering servo and throttle motor
    - Debug visualization (ROI mask, warped view, sliding window overlay)
    Known limitations:
    - Steering angle estimation is still under calibration
    - PWM mapping requires tuning with real vehicle response
    - ROI and perspective transform parameters are camera dependent
2026-01-20 Add Custom ZED2
    - Implement ZED2 camera URDF Xacro model with right and left lens modules
    - Configure stereo camera sensors in Gazebo with Gaussian noise simulation
    - Add Gazebo plugins for image capture (640x480 resolution at 30 FPS)
    - Integrate ROS-Gazebo bridges for image and camera_info topics
    - Define optical frames with correct transformations for vision processing
    - Update main URDF file to include ZED2 camera model
    - Configure camera visualization in RViz with image display plugins
    - Set noise parameters and capture range (0.1m - 15m)
    - Implementar modelo URDF Xacro de cámara ZED2 con lentes derecho e izquierdo
    - Configurar sensores de cámara estéreo en Gazebo con ruido g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
    [common_properties.xacro, traxxas.urdf.xacro, zed2.xacro]
2026-01-20 updated lens 'x' position
    [zed2.xacro]
2026-01-20 Add Custom Lane follower Camera
    - Create new camera_lane.xacro file with lane follower camera model
    - Include new camera in robot main assembly (traxxas.urdf.xacro)
    - Configure camera geometry, inertial properties and Gazebo sensors for lane follower
    - Add Gazebo-ROS bridge topics for lane follower camera image and camera_info streams
    - Add lane follower camera visualization to RViz configuration
    - Add camera links (base, pose, lens, optical) to RViz display configuration
    - Include "white" material in common properties for camera base
    - Nuevo archivo camera_lane.xacro con modelo de cámara para seguimiento de carriles
    Incluir nueva cámara en el ensamblaje principal del robot (traxx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
    [camera_lane.xacro, common_properties.xacro, traxxas.urdf.xacro]
2026-01-22 parking_lidar
    parking lidar pkg containing perception, fsm and control -test No.1
2026-01-22 Add LiDAR sensor
    - LiDAR sensor integration for the Traxxas robot.
    - LiDAR currently configured to have a 360° view for the /traxxas/scan topic.
    - LiDAR sensor to be used for autonomous parking
    - Integración del sensor LiDAR para el robot Traxxas.
    - LiDAR configurado actualmente para tener una vista de 360° en el tópico /traxxas/scan.
    - Sensor LiDAR que será utilizado para estacionamiento autónomo.
    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
    [lidar.xacro, traxxas.urdf.xacro]
2026-01-22 Traxxas v2
    - Configured Custom ZED 2 camera position to be positioned higher.
    - Created base stand for the ZED 2 camera to position int higher and more chassis-centered in x axis.
    - Removed secondary camera intended for line following.
    - Modifications made to optimize sensor usage and for line-following tests using the ZED 2 camera.
    - Se configuró la posición personalizada de la cámara ZED 2 para colocarla a mayor altura.
    - Se creó una base (stand) para la cámara ZED 2 con el fin de elevarla y centrarla mejor respecto al chasis en el eje x.
    - Se eliminó la cámara secundaria destinada al seguimiento de línea.
    - Se realizaron modificaciones para optimizar el uso de sensores y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
    [traxxas.urdf.xacro, zed2.xacro]
2026-01-23 Track World Integrated
    - tools folder created.
    - Added Python code for .sdf Gazebo world generation using a .png image.
    - Base .png image and .sdf generator added to the tools folder.
    - worlds folder created.
    - new .sdf Gazebo world added to the worlds folder
    - worlds folder added to the CMake install list for package building.
    - Launch file configured to use the track_world.sdf Gazebo world for the simulation.
    - Edited robot spawning position and orientation.
    - Carpeta tools creada.
    - Se agregó código Python para la generación de mundos .sdf de Gazebo usando una imagen .png.
    - Se agregó imagen .png base y generador .sdf a la carpeta tools.
    - Carpeta worlds creada.
    - Nuevo mundo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
    [track_world.sdf]
2026-01-26 Lane dectector node improvements:
    - Real-time camera capture using ZED 2
    - Sliding window lane detection algorithm
    - Polynomial lane fitting for lane curvature
    - Curvature estimation and measurement
    - Steering angle computation using vehicle kinematics (Ackermann model)
    - Conversion from steering angle to PWM output for servo control
    - Center line noise reduction still needs improvement
    - Warp transformation fo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
2026-01-27 Create a 3d piece from the technical drawing versions for the Platform Deck, upside, down and joined
    [Platform_Deck.ipt, Platform_Deck_V3_2.ipt, Platform_Deck_V3_3.ipt]
2026-01-28 Lane detector node improvement: - Improved black color filtering with morphological operations - Applied ROI masking before Canny edge detection - Implemented perspective warping for bird's-eye view 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
    - Sliding window needs improvement for single lane detection instead of both
    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
2026-01-29 Dual stereo camera lane detection with independent curve analysis
    Major refactoring of lane detection system to use both ZED camera eyes:
    Features:
    - Implemented dual-eye processing: left and right images analyzed independently
    - Separate lane detection pipeline for each camera perspective
    - Independent curvature calculations per eye for improved robustness
    - Enhanced black color filtering with morphological operations (CLOSE)
    - Applied ROI masking optimized for each camera view before Canny edge detection
    - Perspective warping to bird's-eye view for accurate lane geometry analysis
    - Improved sliding window algorithm with better window tracking
    - Robust steering angle calculation that handl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
2026-01-31 Add all the files in AutoCAD and Inventor
    [platform_deck.ipt, platform_deck_technical_drawing.dwg, platform_deck_v3_2.ipt, platform_deck_v3_2_technical_drawing.dwg, platform_deck_v3_3.ipt, platform_deck_v3_3_technical_drawing.dwg]
2026-02-03 Created traxxas_cmd_sim pkg
    - Created ROS 2 package for physical or virtual PWM signal translation in the /cmd_vel topic of the traxxas_robot_simulation package.
    - Creado paquete de ROS 2 para traducir señales físicas o virtuales de PWM al tópico /cmd_vel del paquete traxxas_robot_simulation.
    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
2026-02-04 Created cmd_sim node
    - Created ROS 2 Node
    - Implemented subscriber to topics /throttle_motor & /direction_servo to receive 14 bits PWM signals for both trhottle and direction
    - Maps received PWM values into -1 to 1 values to publish en /cmd_vel topic
    - Further work needed to correct steering, since the simulated robot in Gazebo shows maximum steering in both directions, despite the imput being intermediate values.
    - Creado Nodo ROS 2
    - Implementado suscriptor a tópicos /throttle_motor y /direction_servo para recibir señales PWM de 14 bits tanto para throttle como dirección
    - Mapea valores PWM recibidos a valores de -1 a 1 para publicar en tópico /cmd_vel
    - Trabajo adicional nece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
2026-02-04 Update robot description - Updated chassis height - Updated camera image resolution - Updated rviz configuration
    [mobile_base.xacro, zed2.xacro]
2026-02-05 Reworked the lane detection pipeline using ZED stereo images and curvature-based steering control.
    Main changes:
    - Implemented black color filtering in HSV space as the primary lane segmentation method
    - Added aggressive morphological closing to reduce noise in black mask
    - Applied ROI masking after Canny edge detection to limit processing to relevant lane areas
    - Integrated perspective warp to generate a bird’s-eye view before lane fitting
    - Implemented sliding window lane detection on warped binary images
    - Added polynomial fitting and curvature estimation per lane
    - Derived steering angle from lane curvature and mapped it to servo PWM output
    - Integrated left/right camera processing wit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
2026-02-06 traxxas_flashlight_control V2 Updated flashlight control to support RGB LEDs.
2026-02-06 Optimized lane detection pipeline with CUDA and ZED native functions
    - Replaced original image processing pipeline with CUDA-accelerated functions for faster processing (down to 180ms).
    - Integrated ZED native functions for image retrieval to improve performance and reliability.
    - Replaced CPU-based filters with GPU-accelerated ones using OpenCV CUDA (CLAHE, Gaussian filter, Canny edge detection).
    - Updated the lane detection logic to support CUDA image processing, significantly improving processing speed.
    - Kept the existing sliding window and curvature calculation methods for lane detection.
    - Improved the quality of edge detection by adding CLAHE contrast enhancement on gray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
2026-02-17 Updated robot simulation with PWM - Configured direction calculation using Ackermann model formula ω = V / L * tan(δ) - Updated launch file to execute PWM - cmd_vel node - Updated lidar position to m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
    [lidar.xacro, mobile_base.xacro]
2026-02-17 Enhanced lane detection robustness with noise filtering and stability improvements
    - Added morphological operations (opening 11x11, closing 5x10) to reduce noise artifacts in binary threshold
    - Implemented masked Canny edge detection using white threshold as mask for cleaner edge detection
    - Added histogram smoothing with Gaussian blur (51px kernel) for more stable lane base detection
    - Added polynomial fit validation to reject invalid curvatures (|a| > 0.001, |b| > 5)
    - Implemented sliding window center movement constraint (max 40px jump) to prevent erratic tracking
    - Fine-tuned CLAHE clipLimit (3.0→1.5) and binary threshold (200→195) to reduce sensitivity
    - Improved curva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
2026-03-04 Updated robot simulation to operate with ZED common topics
    [zed2.xacro]
2026-03-09 Add traxxas_pose_estimation ROS2 package
    Add a new ROS2 package for pose estimation of the Traxxas platform.
    The package integrates encoder AS5048A data from the motor, IMU orientation from the BNO055 sensor, and steering commands to estimate the vehicle pose.
    Included nodes:
    - serial_sensors_node: reads encoder and IMU data from the ESP32 over serial
    - steering_angle_node: converts steering PWM commands to steering angle
    - ackermann_odom_node: computes odometry using Ackermann kinematics
    - pose_traxxas_node: publishes a simplified pose estimate (x, y, theta)
    A bringup launch file is also included to start all nodes together.
2026-03-30 unify ultrasonic, IR sensors and battery on ESP32
    - Integrated 3 ultrasonic sensors and 1 IR sensor.
    - Fixed reading and calibration logic for the 3-cell LiPo battery.
    - Implemented multitasking with millis() to send data to ROS at 30Hz without OLED blocking.
    [ESP32_battery_ultrasonic_infrared.ino]
2026-03-30 Create traxxas_battery_monitor ROS 2 package
    - Created ament_python package for battery monitoring.
    - Added BatteryMonitorNode to read mixed serial data from ESP32.
    - Implemented logic to filter out 30Hz sensor data and process 2Hz battery data.
    - Publishing battery status using standard sensor_msgs/BatteryState.
2026-03-30 Add parking simulation package
    This package handles the autonomous parking simulation. It includes 3 core nodes:
    - lidar_processor: Reads and processes data from the LiDAR sensor.
    - fsm_parking: Finite State Machine that manages the parking logic and decisions.
    - parking_controller: Executes movement commands to drive the vehicle.
2026-03-30 Add autonomous parking system for real hardware
    Migrated the parking system from simulation to the physical vehicle. Key updates:
    - lidar_processor: Tuned filtering parameters for the real LiDAR sensor noise.
    - fsm_parking3: Adjusted the state machine logic for real-world physical constraints and sensor timings.
    - parking_controller5: Calibrated movement commands (steering and throttle) for the physical Traxxas actuators.
    [correction_test.py, fsm_parking3.py, lidar_processor.py, parking_controller5.py, test_freno.py, test_motors.py]
2026-03-31 Add Euler angle publishing to serial sensors node
    Added publishing of Euler angles to the Vector3Stamped topic.
2026-03-31 Changed Throttle PWM to 2625 for testing conditions
2026-03-31 Stereo lane detection node with YOLO + Kalman filter: Implements a ROS2 node (LaneDetectorNode) that performs real-time lane detection using a YOLOv8 segmentation model (TensorRT) on both eyes of a Z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
    Key components:
    - ZED camera producer thread: reads frames from live camera or .svo2
    file and feeds a single-slot queue at ~10 fps
    - YOLO inference: runs batched segmentation on left+right frames using
    a .engine TRT model; masks are GPU-resized to original resolution
    - ROI + perspective warp: trapezoidal region of interest per eye is
    warped to a top-down (bird's-eye) view before fitting
    - Sliding window: 12-window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
    [lane_detector_yolo.py]
2026-04-02 feat(launch): integrate camera, IMU, and fix master launch
    New features:
    - Integrated the 'lane_detector_camera.py' script as an executable node within the package.
    - Added the 'lane_detector_camera' node to the master launch file to start vision automatically.
    - Included the execution of the IMU and odometry launch file ('bringup_launch.py' from 'traxxas_pose_estimation') in the master launch.
    Bug fixes:
    - Fixed the executable for 'parking_controller_traxxas_node' (it was mistakenly calling 'fsm_parking3', which duplicated the state machine).
    - Added 'lidar_processor_node' to the LaunchDescription list, as it was declared but not actually being executed.
    [lane_detector_camera.py]
2026-04-09 refactor: update parameters for wheel configuration and remove unused steering angle node
2026-04-13 Update ESP32_battery_ultrasonic_infrared.ino
    Changed ECHO pin from D12 to D19 due to ESP32 boot issues
    [ESP32_battery_ultrasonic_infrared.ino]
2026-04-13 Update battery_node.py
    Changed serial port to USB1
2026-06-15 Moved Traxxas_V1 models and technical drawings to TRAXXAS_V1/MODEL & TRAXXAS_V1/ DRAW folders
    [Platform_Deck.ipt, Platform_Deck_V3_2.ipt, Platform_Deck_V3_3.ipt, platform_deck.ipt, platform_deck_technical_drawing.dwg, platform_deck_v3_2.ipt, platform_deck_v3_2_technical_drawing.dwg, platform_deck_v3_3.ipt]
2026-06-15 DISPLAY_BASE Uploaded CAD models/Technical Drawings/STL printable files
    [base_inferior.SLDDRW, base_inferior.SLDPRT, base_inferior.STL, base_superior.SLDDRW, base_superior.SLDPRT, base_superior.STL, ensamblaje_base.SLDASM, pilar.SLDDRW]
2026-06-15 Moved CAD models
    [platform_deck.ipt, platform_deck_v3_2.ipt, platform_deck_v3_3.ipt]
2026-06-15 Stream ZED depth and XYZRGBA point cloud alongside stereo
    The Jetson bridge previously published only the JPEG-compressed stereo
    pair on /zed/stereo/compressed. Add two topics so the obstacle-detection
    pipeline can consume metric 3D data without re-opening the camera:
    - /zed/depth_registered (Image, 32FC1, meters)
    - /zed/xyzrgba_image (Image, 32FC4, XYZ + packed RGBA)
    Enable PERFORMANCE depth mode with metric units and a right-handed
    Y-up coordinate frame, and retrieve DEPTH and XYZRGBA on every grab.
    The XYZRGBA channel layout (X/Y/Z/RGBA) lets see_obstacle_node reuse
    its existing point_cloud_np[:, :, :3] logic unchanged.
2026-06-15 TRAXXAS_V2 Uploaded CAD models/Technical Drawings
    [HC-SR04.SLDPRT, ZED2i.step, base_lidar.SLDDRW, base_lidar.SLDPRT, base_zed.SLDDRW, base_zed.SLDPRT, ensamblaje_basez_2_zed.SLDASM, left_ultrasonic_2_base - copia.SLDASM]
2026-06-15 On-board lane detector with 3-factor adaptive steering
    Monolithic node that runs on the car itself: it opens the ZED directly
    with pyzed and grabs frames in a producer thread, so capture, YOLO
    segmentation and control all live in one process.
    Per-eye pipeline: YOLO mask -> ROI -> bird's-eye warp -> sliding-window
    quadratic fit -> curvature. Steering is an adaptive fusion of three
    estimators (sliding-window curvature, linear slope of the warped lane,
    and the previous frame's angle), weighted by how tight the curve is,
    then mapped to a servo PWM. Includes SVO playback for offline testing,
    optional visualization, a curve-mode telemetry log, and a SIGINT handler
    that publishes a safe stop befor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
    [lane_detector_yolo.py]
2026-06-15 External-PC variant with lateral centroid correction
    Same perception and steering-fusion logic as the on-board detector, but
    runs on an external PC: instead of opening the ZED it subscribes to
    /zed/stereo/compressed, decodes the JPEG and splits the stereo pair into
    two eyes, offloading YOLO inference from the Jetson.
    Adds a lateral-offset correction: lateral_offset() estimates the lane
    center vs. the car center and nudges the fused steering angle to keep the
    car centered in the lane.
    Known limitation: the centroid is computed from the raw detected lane
    pixels (mean x of the warped masks), which is noisy and unreliable. It
    needs a more robust method (e.g. derived from the fitted centerline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
    [lane_detector_yolo_external.py]
2026-06-15 Pure-pursuit controller with real ZED undistortion
    External-PC node (subscribes to /zed/stereo/compressed) that steers with
    Pure Pursuit instead of the angle-fusion approach: it builds the BEV
    centerline from the left/right lane fits and aims at a look-ahead point
    (0.60 m) to compute the servo angle.
    Unlike the other variants, each eye is undistorted with the real
    intrinsics and distortion coefficients measured from our own ZED
    (per-eye camera matrices + coeffs applied via cv2.undistort) before the
    ROI/warp stage, so the bird's-eye geometry matches the physical camera.
    Also integrates traffic-sign detection (crosswalk/stop via a second
    engine) with timed stops, and publishes an LED state o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
    [lane_detector_purePursuit.py]
2026-06-15 autonomous parallel-parking subsystem
    Add the four-node parallel-parking pipeline for the Traxxas:
    - fsm_parking3.py: high-level state machine (ParkingFSM3) that walks the
    maneuver ORIENTANDOSE -> BUSCAR_CAJA -> BUSCAR -> ESPERAR -> ALEJARSE
    -> ENTRAR_DIAGONAL -> ENDEREZAR -> ESTACIONANDO -> STOP, driven by
    perception flags and controller feedback; publishes /parking/state.
    - lidar_processor.py: bins the /scan ranges into front/right/left/rear
    sectors by angle and publishes occupancy flags (FC/RF/LF/RC) plus the
    measured side distances (RD/LD) on /parking/perception.
    - parking_controller_traxxas.py: low-level controller that executes the
    per-state steering/throttle commands, r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
2026-06-15 ZED visual-odometry variant with yaw/pose fusion
    Experimental parallel versions of the parking nodes that add ZED visual
    odometry on top of the lidar + IMU base:
    - lane_detector_camara_28.py: extends the lane detector to also publish
    the ZED positional tracking (pose, IMU, yaw, tracking state) on /zed/*,
    converting the orientation quaternion to a yaw angle.
    - parking_controller_28.py: extends the controller to fuse the ZED yaw
    and pose with the IMU/lane-angle estimate (yaw blending + freshness
    checks) and to publish the yaw actually used and the traveled distance
    (/parking/yaw_used, /parking/state_distance), for more reliable
    orientation and stopping.
2026-06-15 launch file for the ZED-odometry parking stack
    Bring up the full parallel-parking system (the _28 visual-odometry
    variant) from a single launch:
    - includes the RPLIDAR A3 launch (serial port via the lidar_serial_port
    argument, default /dev/rplidar) and the traxxas_pose_estimation
    bringup (IMU, odometry and serial control);
    - starts the parking nodes: lane_detector_camara_28, lidar_processor,
    parking_controller_28 (serial_port=/dev/trx_ultrasonicos) and
    fsm_parking3;
    - registers an OnProcessExit handler tied to lidar_processor that
    triggers the RPLIDAR launch when that node exits.
2026-06-15 standalone HLS + Hough lane-angle prototype
    Add prueba.py, an offline sandbox (not a ROS node) for tuning the
    camera-only lane pipeline: reads a frame via cv2.VideoCapture, crops one
    lens of the stereo image, extracts white lane pixels in HLS, runs Canny
    + HoughLinesP over a ROI, fits the left/right lines and derives a
    steering angle from the lane-center offset, with EMA smoothing and a
    debug overlay. Used to prototype the approach before porting it into the
    ROS lane_detector nodes.
2026-06-16 TRAXXAS_V3 Uploaded CAD models/Technical Drawings/STL printable files
    - Reduced second floor length to give space to LIDAR base on the first floor
    - Modified Ultrasonic sensor base into a back-defense-type harness to support sensors required angle and infrared sensor if required
    - Adapted to new smaller motor platform
    [HC-SR04.SLDPRT, LIDAR.SLDASM, LIDAR.SLDPRT, LIDAR.STEP, LIDAR_1.SLDPRT, LIDAR_1.STEP, LIDAR_2.SLDPRT, LIDAR_2.STEP]
2026-06-16 Add firmware files for IMU and Encoder
    Two encoder+IMU firmware variants for AS5048A + BNO055, publishing CSV over Serial at 50 Hz for ROS2:
    - ESP32: publishes incremental distance (ds), encoder sampled at 2 kHz via micros()
    - ESP32-C3: publishes angular velocity (omega) using EMA filter over 100 ms window
2026-06-16 TRAXXAS_V4 Uploaded CAD models/Technical Drawings/STL printable files - Changed bodywork to adapt to chassis
    [Carroceria2_1_4.SLDDRW, Carroceria2_1_4.SLDPRT, Carroceria2_1_4.STL, Carroceria2_2.SLDDRW, Carroceria2_2.SLDPRT, Carroceria2_2.STL, HC-SR04.SLDPRT, LIDAR.SLDASM]
2026-06-16 Add ROS2 obstacle avoidance nodes based on pose estimation with CSV routines - Add traxxas_obstacle_avoidance package - Update traxxas_pose_estimation node and launch - Pose-based logic not validated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
    [traxxas_waypoints_obstacle.csv]
2026-06-16 Update ZED stereo bridge node to publish depth
    Extend existing node to publish both stereo compressed image and depth map:
    - Stereo frame (left + right): JPEG compressed at 70% quality on /zed/stereo/compressed
    - Depth map: float32 meters on /zed/depth_registered (32FC1 encoding)
    Camera initialized at HD720 30fps with PERFORMANCE depth mode.
2026-06-16 Add traxxas_stop package ROS2 package that stops the vehicle on stop sign or crosswalk detection.
    Detection: stop_sign_node (HSV + contour) and crosswalk_node (stripe projection),
    each with a score-based confirmation filter. stop_event_merger_node combines both sources.
    Control: stop_routine_action_server runs a FSM (BrakeRamp→StopWait→ResumeRamp)
    with encoder feedback. pwm_controller handles throttle and steering PWM.
    traxxas_watchdog_node applies a safe brake if commands stop for >0.3 s.
2026-06-17 PWM values mapped to real degrees depending on the motor
    [pwm.xlsx]
2026-06-19 Folder that contains all de AI model trained for the tournament
    [results.csv]
2026-06-19 Codes used to train de AI models added
2026-06-19 name changed
    [results.csv]
2026-06-19 CAD REAME documentation README file added
2026-06-19 Enhance README with Display Base details and images
    Updated the README to include detailed sections for the Display Base model, including links to technical drawings, CAD files, and printable files. Added descriptions and images for the parts that comprise the model.
2026-06-26 Readme abouut Jetson Software Added
2026-10-02 Add parking_world.sdf for reference purposes
    Add the original autonomous parking simulation world to the traxxas_robot_simulation package.
    DISCLAIMER: This environment is included strictly as an architectural reference. It is not fully compatible with the current version of the robot model (traxxas_robot_description) out-of-the-box. Due to recent updates in the URDF/Xacro, sensor frames, kinematics, and topic mappings have changed. Any legacy algorithms testing this world will require manual adaptations to work with the current vehicle configuration."
    [parking_world.sdf]
